tslever/Inventor/(list of files, cad)

Other CAD files:
Mobility/Additional_Building/Additional_Building.dwg
Mobility/Attic/Existing_Attic.dwg
Mobility/Basement/Existing_Basement.dwg
Mobility/Existing_House.dwg
Mobility/First_Floor/Finished_First_Floor.dwg
Mobility/Basement/Finished_Basement.dwg
Mobility/First_Floor/Existing_First_Floor.dwg
Mobility/Transition_For_Existing_Basement_And_First_Floor.dwg
Mobility/Replumbing_Mobility.dwg
Mobility/Transition_For_Finished_Basement_And_First_Floor.dwg
Mobility/Additional_Building/Additional_Building.iam
Mobility/Additional_Building/Area_With_Additional_Building.iam
Mobility/Additional_Building/Beam.iam
Mobility/Additional_Building/Beam.ipt
Mobility/Additional_Building/Bottom_Of_End_Cap_Of_Intake_Vent.ipt
Mobility/Additional_Building/Cage.iam
Mobility/Additional_Building/California_Corner.iam
Mobility/Additional_Building/Ceiling_Joist.ipt
Mobility/Additional_Building/Coil_Of_Wire.iam
Mobility/Additional_Building/Coil_Of_Wire.ipt
Mobility/Additional_Building/DensGlass.iam
Mobility/Additional_Building/DensGlass_With_Dimensions_12_x_57.9155_Inches.ipt
Mobility/Additional_Building/DensGlass_With_Dimensions_19.831_x_36.5_Inches.ipt
Mobility/Additional_Building/DensGlass_With_Dimensions_19.831_x_96_Inches.ipt
Mobility/Additional_Building/DensGlass_With_Dimensions_36.5_x_48_Inches.ipt
Mobility/Additional_Building/DensGlass_With_Dimensions_48_x_84.5_Inches.ipt
Mobility/Additional_Building/DensGlass_With_Dimensions_48_x_96_Inches.ipt
Mobility/Additional_Building/Drip_Edge_For_Back_With_Length_48.752_Inches.ipt
Mobility/Additional_Building/Drip_Edge_For_Back_With_Length_97.504_Inches.ipt
Mobility/Additional_Building/Drip_Edge_For_Front_With_Length_48.919_Inches.ipt
Mobility/Additional_Building/Drip_Edge_For_Front_With_Length_97.837_Inches.ipt
Mobility/Additional_Building/Drip_Edge_For_Side.ipt
Mobility/Additional_Building/Earth.ipt
Mobility/Additional_Building/Fascia_For_Back.ipt
Mobility/Additional_Building/Fascia_For_Front.ipt
Mobility/Additional_Building/Fascia_For_Side.ipt
Mobility/Additional_Building/Fascia_Vent_With_Length_13.75_Inches.ipt
Mobility/Additional_Building/Fascia_Vent_With_Length_14.5_Inches.ipt
Mobility/Additional_Building/Fiber_Cement_Board_For_Back_Wall.ipt
Mobility/Additional_Building/Fiber_Cement_Board_For_Side_Wall.ipt
Mobility/Additional_Building/First_Shingle_Over_Intake_Vent_With_Length_28.375_Inches.ipt
Mobility/Additional_Building/First_Shingle_Over_Intake_Vent_With_Length_30.45_Inches.ipt
Mobility/Additional_Building/First_Shingle_Over_Intake_Vent_With_Length_39.375_Inches.ipt
Mobility/Additional_Building/Floor_System.iam
Mobility/Additional_Building/Framing_For_Bathroom_Window.iam
Mobility/Additional_Building/Framing_For_First_Floor.iam
Mobility/Additional_Building/Framing_For_First_Floor_Window.iam
Mobility/Additional_Building/Framing_For_Roof.iam
Mobility/Additional_Building/Framing_For_Second_Floor.iam
Mobility/Additional_Building/Framing_For_Second_Floor_Window.iam
Mobility/Additional_Building/Framing_For_Side_Window.iam
Mobility/Additional_Building/Grid_Of_Piers.iam
Mobility/Additional_Building/Ground_Rod.ipt
Mobility/Additional_Building/Header_With_Dimensions_0.5_x_3.5_x_39_Inches.ipt
Mobility/Additional_Building/Header_With_Dimensions_0.5_x_3.5_x_41.25_Inches.ipt
Mobility/Additional_Building/Header_With_Dimensions_0.5_x_3.5_x_50.25_Inches.ipt
Mobility/Additional_Building/Header_With_Dimensions_0.5_x_5.5_x_41.25_Inches.ipt
Mobility/Additional_Building/Header_With_Dimensions_0.5_x_5.5_x_50.25_Inches.ipt
Mobility/Additional_Building/Header_With_Dimensions_1.5_x_3.5_x_39_Inches.ipt
Mobility/Additional_Building/Header_With_Dimensions_1.5_x_3.5_x_41.25_Inches.ipt
Mobility/Additional_Building/Header_With_Dimensions_1.5_x_3.5_x_50.25_Inches.ipt
Mobility/Additional_Building/Header_With_Dimensions_1.5_x_5.5_x_41.25_Inches.ipt
Mobility/Additional_Building/Header_With_Dimensions_1.5_x_5.5_x_50.25_Inches.ipt
Mobility/Additional_Building/Header_With_Dimensions_3.5_x_3.5_x_39_Inches.iam
Mobility/Additional_Building/Header_With_Dimensions_3.5_x_3.5_x_41.25_Inches.iam
Mobility/Additional_Building/Header_With_Dimensions_3.5_x_3.5_x_50.25_Inches.iam
Mobility/Additional_Building/Header_With_Dimensions_3.5_x_5.5_x_41.25_Inches.iam
Mobility/Additional_Building/Header_With_Dimensions_3.5_x_5.5_x_50.25_Inches.iam
Mobility/Additional_Building/Intake_Vent.ipt
Mobility/Additional_Building/Joist_With_Length_144_Inches.ipt
Mobility/Additional_Building/Joist_With_Length_56.75_Inches.ipt
Mobility/Additional_Building/Joist_With_Length_6.5_Inches.ipt
Mobility/Additional_Building/Leak_Barrier.ipt
Mobility/Additional_Building/Maple_Tree.ipt
Mobility/Additional_Building/Mending_Plate.ipt
Mobility/Additional_Building/OSB_For_Front_Roof.ipt
Mobility/Additional_Building/OSB_For_Rear_Roof.ipt
Mobility/Additional_Building/OSB_For_Roof_With_Dimensions_47.416_x_96.ipt
Mobility/Additional_Building/OSB_For_Roof_With_Dimensions_48_x_48.ipt
Mobility/Additional_Building/OSB_For_Roof_With_Dimensions_48_x_96.ipt
Mobility/Additional_Building/OSB_For_Side_And_Back.ipt
Mobility/Additional_Building/OSB_For_Side_And_Top.ipt
Mobility/Additional_Building/OSB_For_Subfloor_With_Dimensions_48_x_48_Inches.ipt
Mobility/Additional_Building/OSB_For_Subfloor_With_Dimensions_96_x_36_Inches.ipt
Mobility/Additional_Building/OSB_For_Subfloor_With_Dimensions_96_x_48_Inches.ipt
Mobility/Additional_Building/OSB_For_Walls_With_Dimensions_15.459_x_48_Inches.ipt
Mobility/Additional_Building/OSB_For_Walls_With_Dimensions_15.459_x_96_Inches.ipt
Mobility/Additional_Building/OSB_For_Walls_With_Dimensions_19.831_x_96_Inches.ipt
Mobility/Additional_Building/OSB_For_Walls_With_Dimensions_37_x_48_Inches.ipt
Mobility/Additional_Building/OSB_For_Walls_With_Dimensions_38.375_x_40.979_Inches.ipt
Mobility/Additional_Building/OSB_For_Walls_With_Dimensions_48_x_48_Inches.ipt
Mobility/Additional_Building/OSB_For_Walls_With_Dimensions_48_x_85_Inches.ipt
Mobility/Additional_Building/OSB_For_Walls_With_Dimensions_48_x_96_Inches.ipt
Mobility/Additional_Building/Pier.iam
Mobility/Additional_Building/Pier.ipt
Mobility/Additional_Building/Plate_With_Length_125_Inches.ipt
Mobility/Additional_Building/Plate_With_Length_132_Inches.ipt
Mobility/Additional_Building/Plate_With_Length_144_Inches.ipt
Mobility/Additional_Building/Plate_With_Length_25_Inches.ipt
Mobility/Additional_Building/Plate_With_Length_60_Inches.ipt
Mobility/Additional_Building/Plate_With_Length_68.5_Inches.ipt
Mobility/Additional_Building/Plate_With_Length_72_Inches.ipt
Mobility/Additional_Building/Plate_With_Length_83.350_Inches.ipt
Mobility/Additional_Building/Plate_With_Length_96_Inches.ipt
Mobility/Additional_Building/Rafter.ipt
Mobility/Additional_Building/Rebar_With_Length_Of_31.56275_Inches.ipt
Mobility/Additional_Building/Rectangle_Of_Underlayment_For_Beam.ipt
Mobility/Additional_Building/Rectangle_Of_Underlayment_For_Joist.ipt
Mobility/Additional_Building/Ring_Of_Rebar.ipt
Mobility/Additional_Building/Saddle_Bracket.ipt
Mobility/Additional_Building/Second_Shingle_Over_Intake_Vent_With_Length_22.375_Inches.ipt
Mobility/Additional_Building/Second_Shingle_Over_Intake_Vent_With_Length_36.45_Inches.ipt
Mobility/Additional_Building/Second_Shingle_Over_Intake_Vent_With_Length_39.375_Inches.ipt
Mobility/Additional_Building/Sheathing_For_Back.iam
Mobility/Additional_Building/Sheathing_For_Front.iam
Mobility/Additional_Building/Sheathing_For_Roof.iam
Mobility/Additional_Building/Sheathing_For_Side.iam
Mobility/Additional_Building/Shingle_With_Dimensions_13.25_x_19.45_Inches.ipt
Mobility/Additional_Building/Shingle_With_Dimensions_13.25_x_22.375_Inches.ipt
Mobility/Additional_Building/Shingle_With_Dimensions_13.25_x_25.45_Inches.ipt
Mobility/Additional_Building/Shingle_With_Dimensions_13.25_x_28.375_Inches.ipt
Mobility/Additional_Building/Shingle_With_Dimensions_13.25_x_30.45_Inches.ipt
Mobility/Additional_Building/Shingle_With_Dimensions_13.25_x_33.375_Inches.ipt
Mobility/Additional_Building/Shingle_With_Dimensions_13.25_x_36.45_Inches.ipt
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
