tslever/Inventor/Mobility/Additional_Building/Additional_Building.pdf

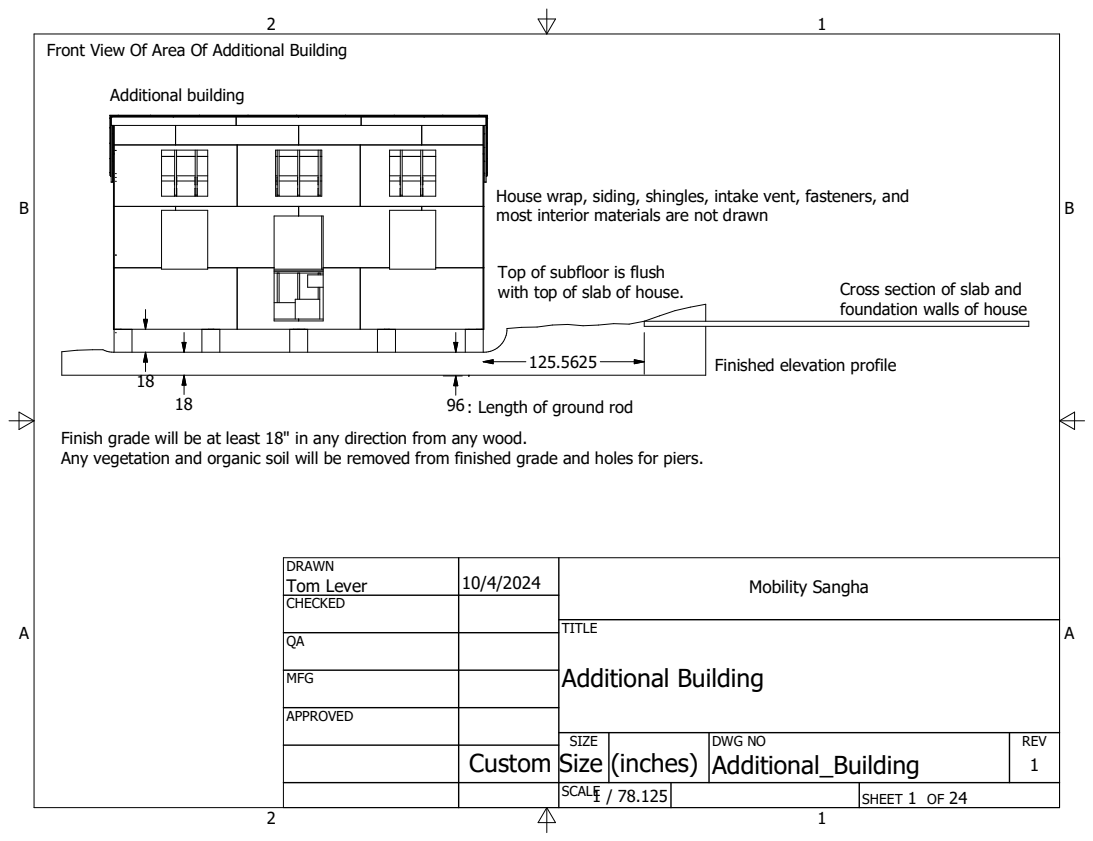
[picture p5: page 1]
SHEET 1 OF 24; DWG NO Additional_Building; TITLE Additional Building; SIZE; SCALE; REV 1; Additional building

Front View Of Area Of Additional Building

House wrap, siding, shingles, intake vent, fasteners, and
most interior materials are not drawn

Top of subfloor is flush
with top of slab of house.

Cross section of slab and
foundation walls of house

Finished elevation profile

96: Length of ground rod

Finish grade will be at least 18" in any direction from any wood.
Any vegetation and organic soil will be removed from finished grade and holes for piers.

DRAWN Tom Lever | 10/4/2024 | Mobility Sangha

CHECKED

MFG

APPROVED

Custom Size (inches)

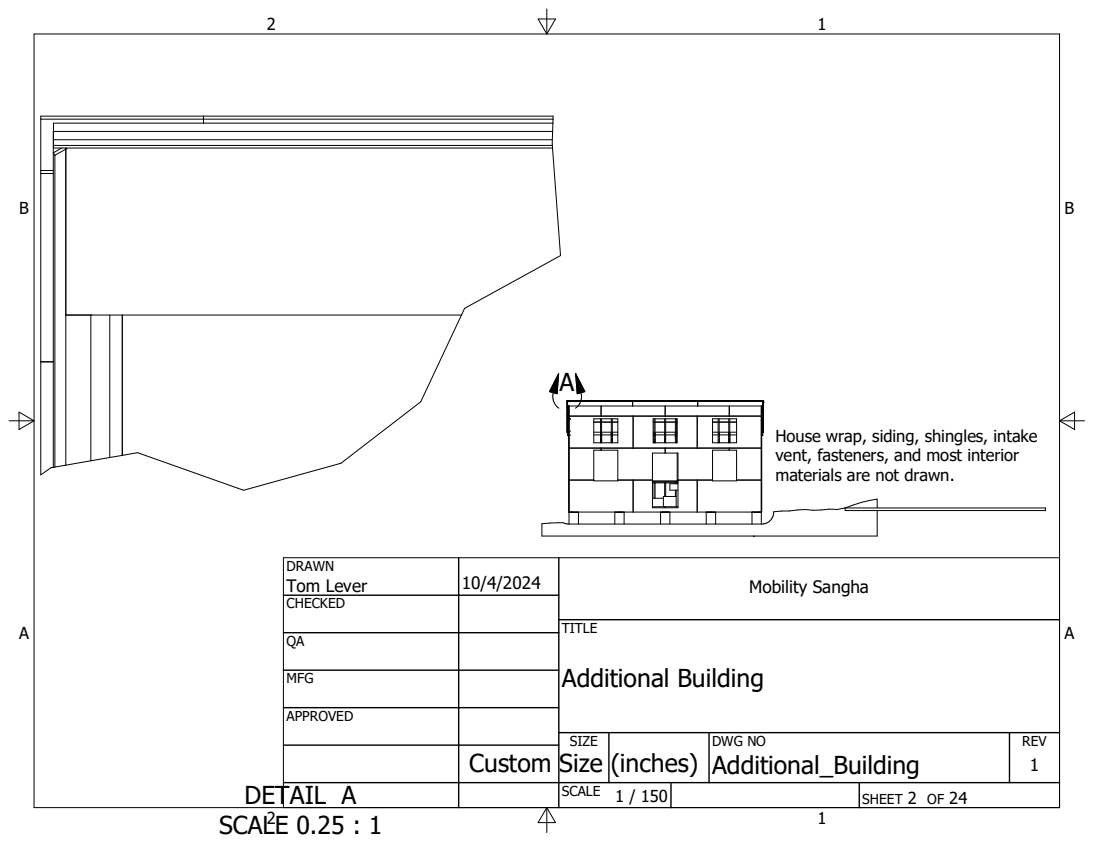
[picture p6: page 2]
DETAIL A SCALE 0.25 : 1; SHEET 2 OF 24; DWG NO Additional_Building; TITLE Additional Building; SIZE; REV 1

House wrap, siding, shingles, intake
vent, fasteners, and most interior
materials are not drawn.

DRAWN Tom Lever | 10/4/2024 | Mobility Sangha

CHECKED

MFG

APPROVED

Custom Size (inches)

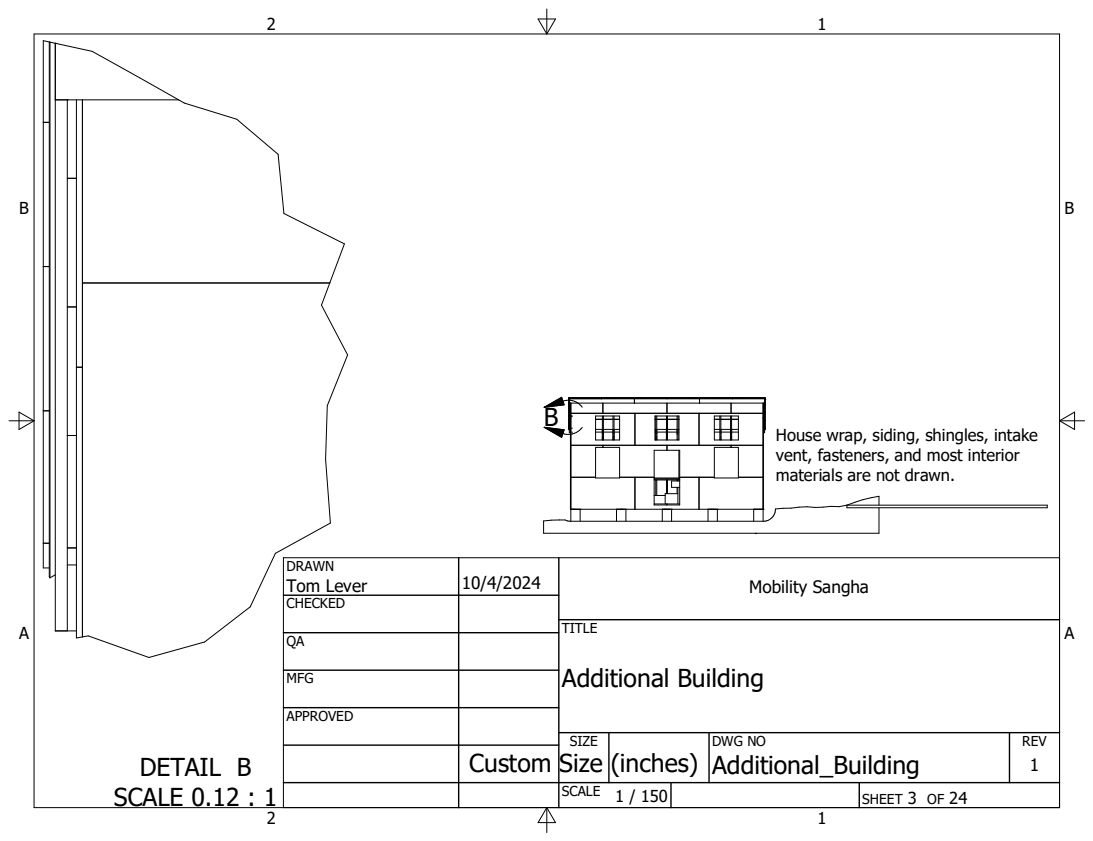
[picture p7: page 3]
DETAIL B SCALE 0.12 : 1; SHEET 3 OF 24; DWG NO Additional_Building; TITLE Additional Building; SIZE; REV 1

House wrap, siding, shingles, intake
vent, fasteners, and most interior
materials are not drawn.

DRAWN Tom Lever | 10/4/2024 | Mobility Sangha

CHECKED

MFG

APPROVED

Custom Size (inches)

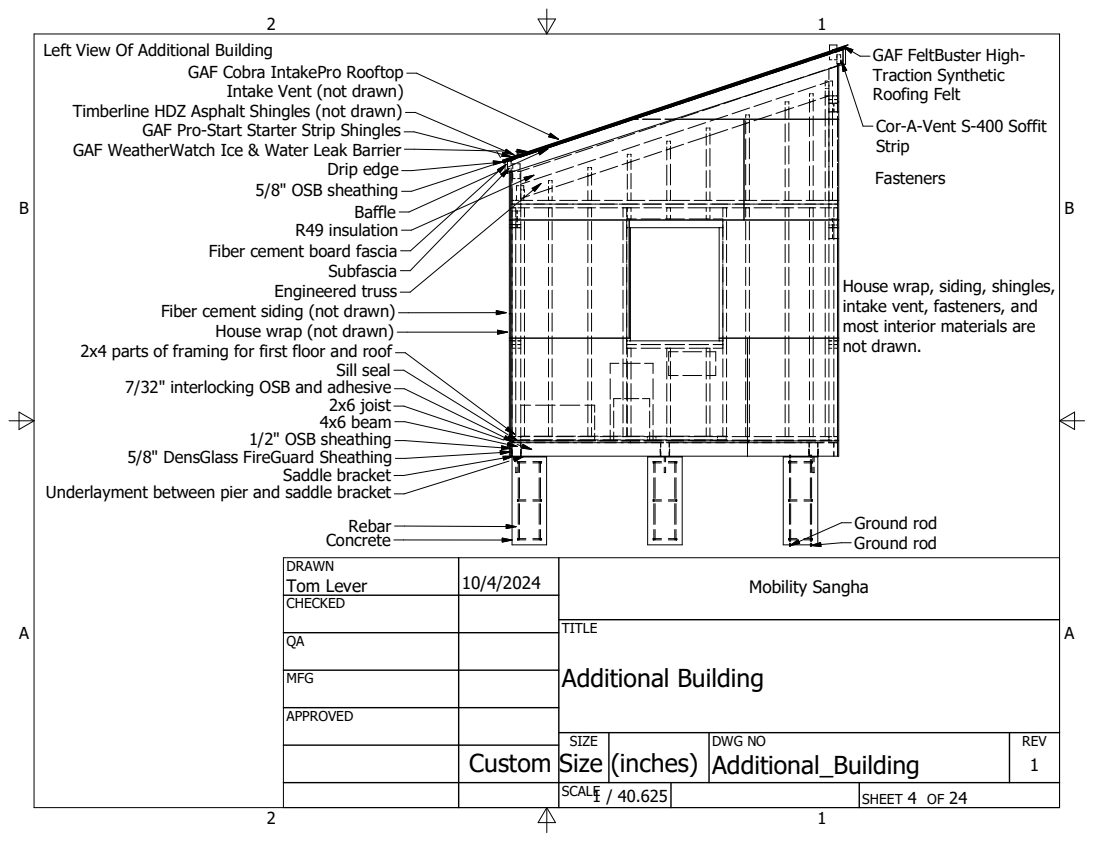
[picture p8: page 4]
SHEET 4 OF 24; DWG NO Additional_Building; TITLE Additional Building; SIZE; REV 1; Concrete; Saddle bracket; 1/2" OSB sheathing; 4x6 beam; 2x6 joist; Sill seal; Engineered truss; Subfascia; Drip edge 5/8" OSB sheathing; R49 insulation; Baffle; Rebar; Ground rod

Left View Of Additional Building

GAF FeltBuster High-
Traction Synthetic
Roofing Felt
Cor-A-Vent S-400 Soffit
Strip
Fasteners

GAF Cobra IntakePro Rooftop
Intake Vent (not drawn)

Timberline HDZ Asphalt Shingles (not drawn)

GAF Pro-Start Starter Strip Shingles

GAF WeatherWatch Ice & Water Leak Barrier

Fiber cement board fascia

House wrap, siding, shingles,
intake vent, fasteners, and
most interior materials are
not drawn.

Fiber cement siding (not drawn)
House wrap (not drawn)

2x4 parts of framing for first floor and roof
7/32" interlocking OSB and adhesive

5/8" DensGlass FireGuard Sheathing

Underlayment between pier and saddle bracket

DRAWN Tom Lever | 10/4/2024 | Mobility Sangha

CHECKED

MFG

APPROVED

Custom Size (inches)

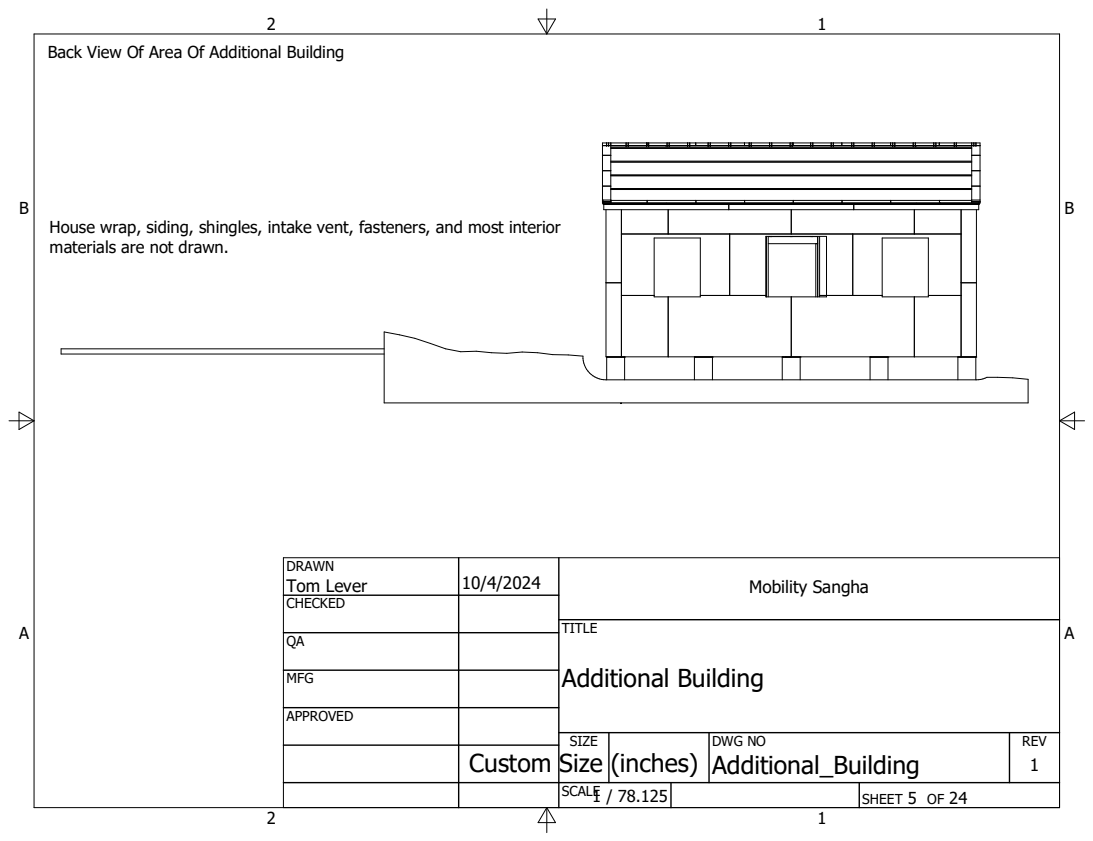
[picture p9: page 5]
SHEET 5 OF 24; DWG NO Additional_Building; TITLE Additional Building; SIZE; REV 1

Back View Of Area Of Additional Building

House wrap, siding, shingles, intake vent, fasteners, and most interior
materials are not drawn.

DRAWN Tom Lever | 10/4/2024 | Mobility Sangha

CHECKED

MFG

APPROVED

Custom Size (inches)

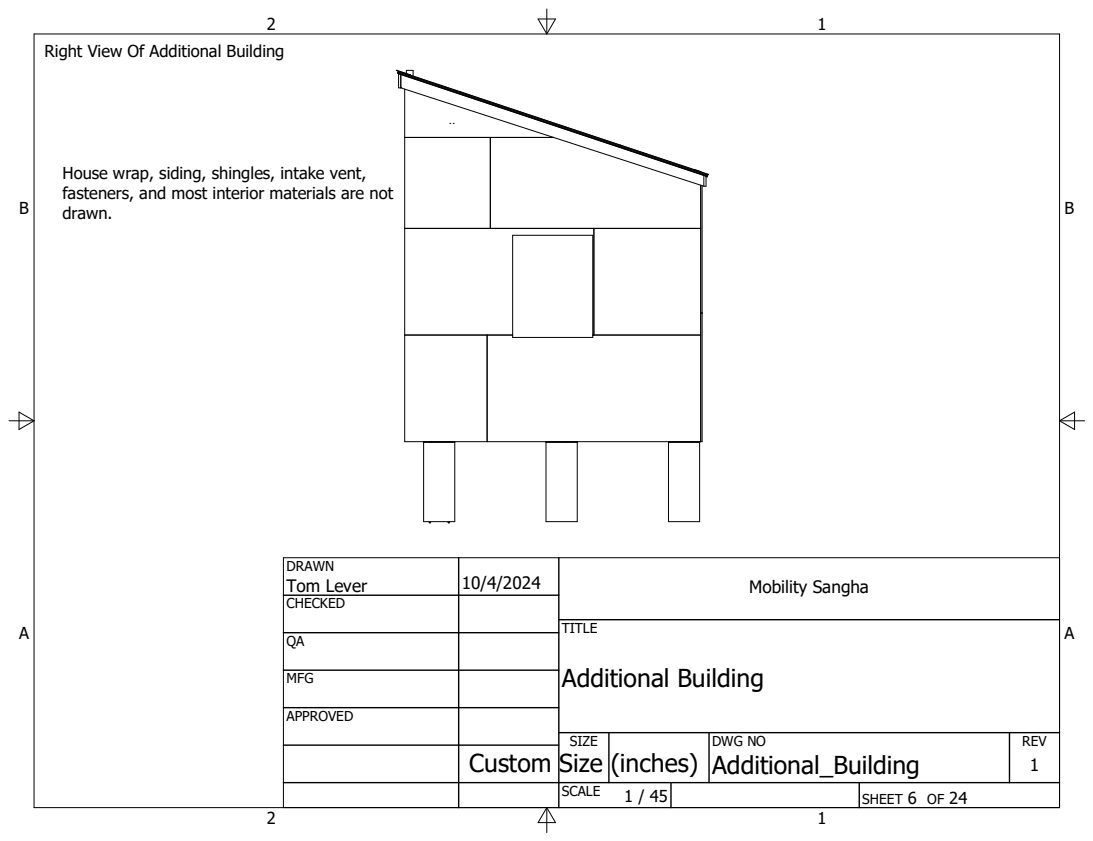
[picture p10: page 6]
SHEET 6 OF 24; DWG NO Additional_Building; TITLE Additional Building; SIZE; REV 1

Right View Of Additional Building

House wrap, siding, shingles, intake vent,
fasteners, and most interior materials are not
drawn.

DRAWN Tom Lever | 10/4/2024 | Mobility Sangha

CHECKED

MFG

APPROVED

Custom Size (inches)

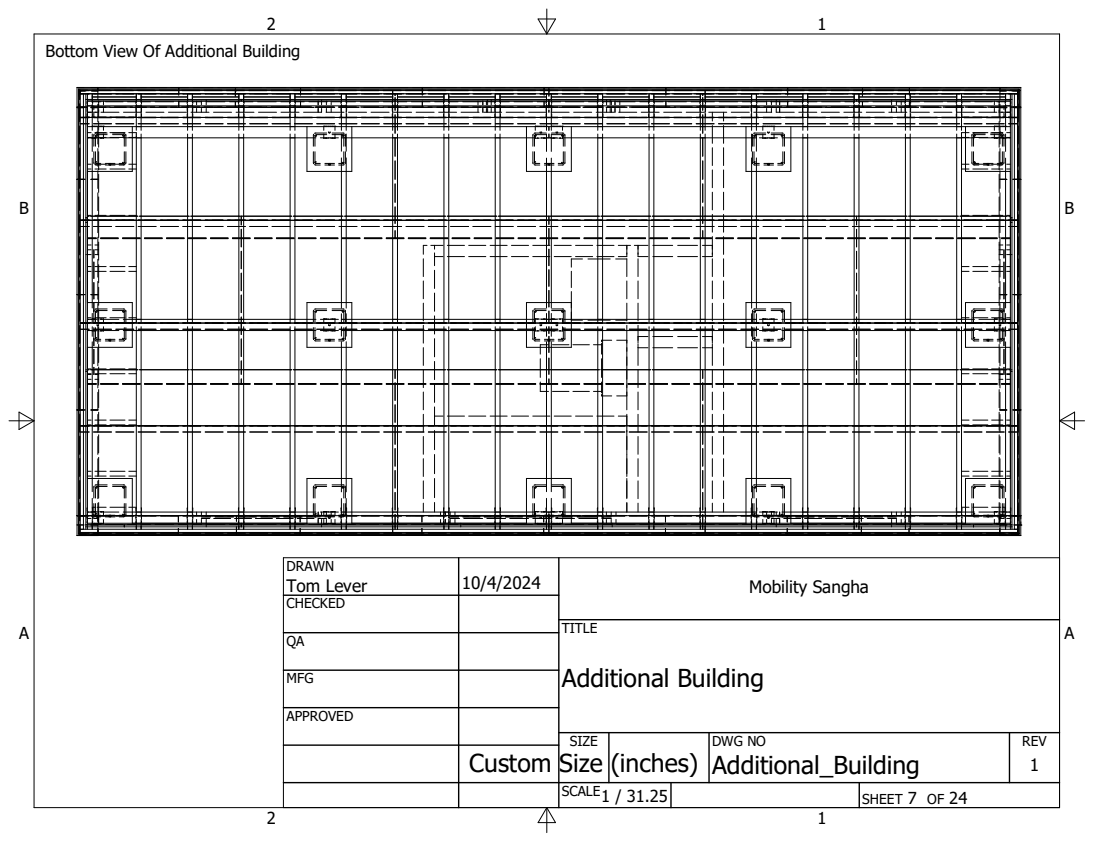
[picture p11: page 7]
SHEET 7 OF 24; DRAWN; CHECKED; MFG; APPROVED; Tom Lever; DWG NO Additional_Building; TITLE Additional Building; SIZE; Mobility Sangha; REV 1

Bottom View Of Additional Building

Custom Size (inches)

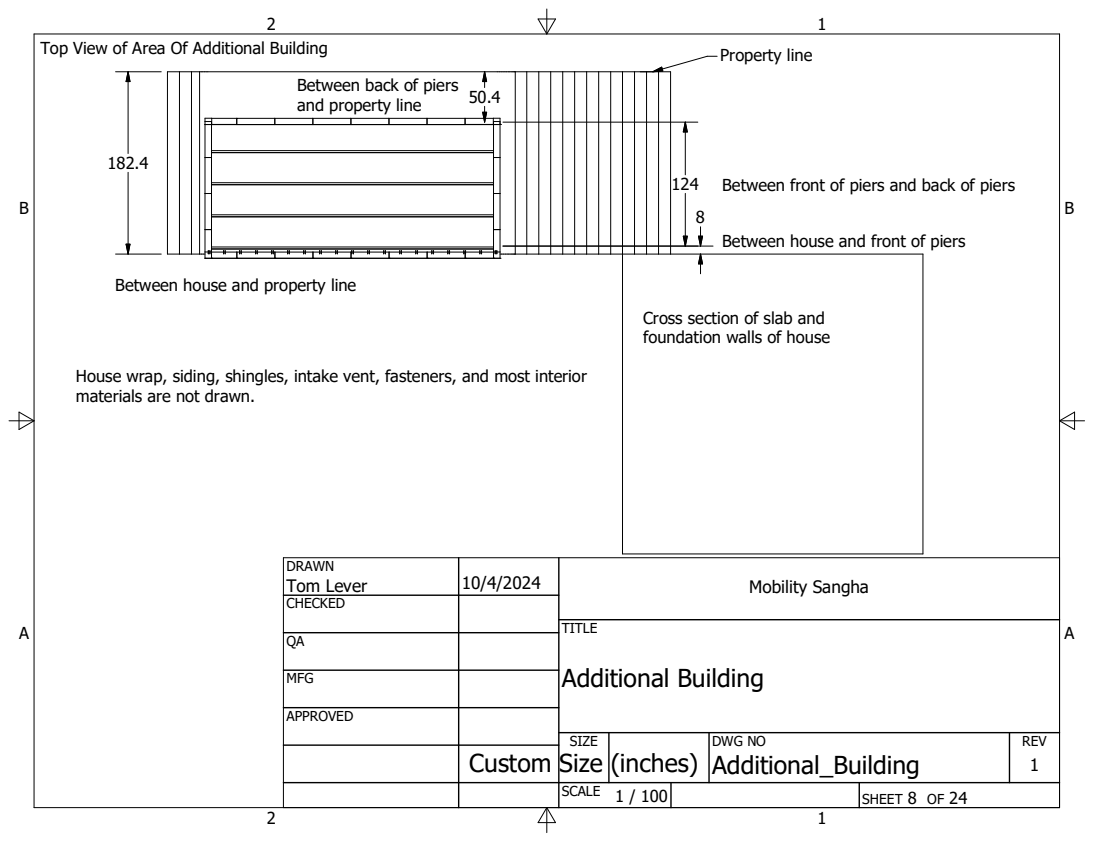
[picture p12: page 8]
SHEET 8 OF 24; DWG NO Additional_Building; TITLE Additional Building; SIZE; REV 1; Property line

Top View of Area Of Additional Building

Between back of piers
and property line

Between front of piers and back of piers
Between house and front of piers

Between house and property line

Cross section of slab and
foundation walls of house

House wrap, siding, shingles, intake vent, fasteners, and most interior
materials are not drawn.

DRAWN Tom Lever | 10/4/2024 | Mobility Sangha

CHECKED

MFG

APPROVED

Custom Size (inches)

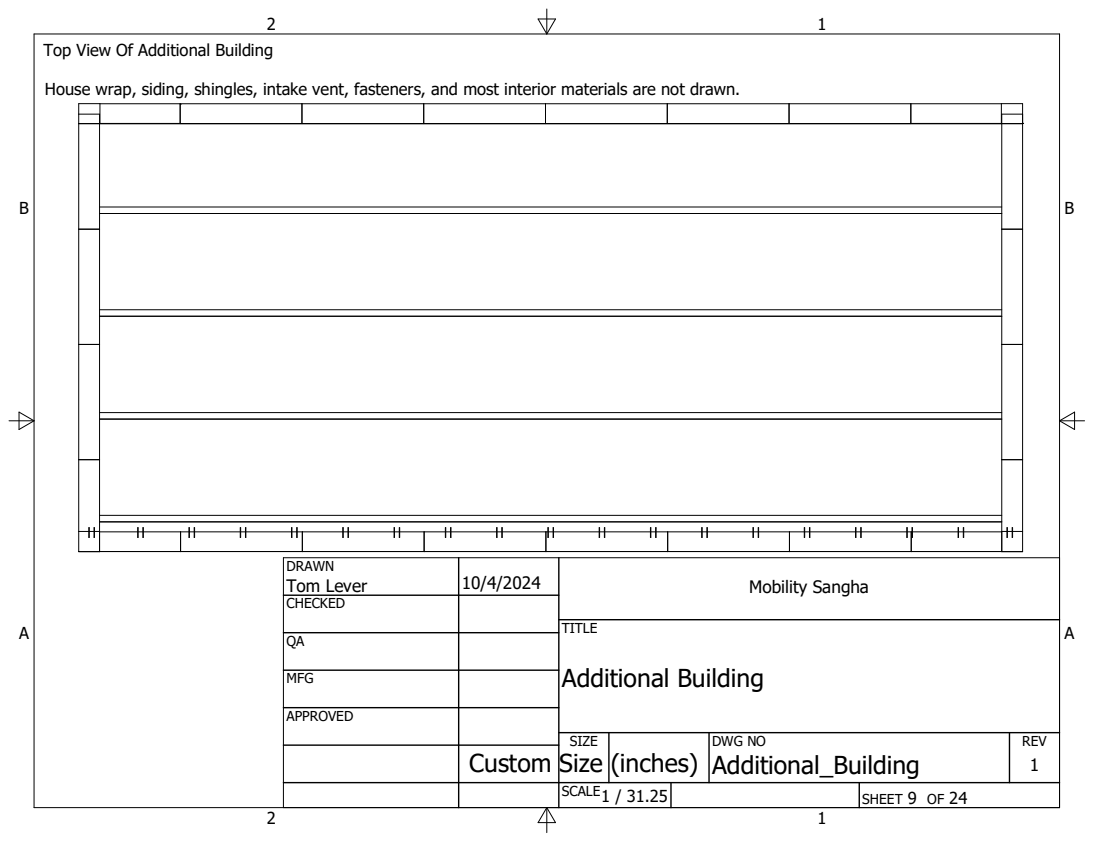
[picture p13: page 9]
SHEET 9 OF 24; DWG NO Additional_Building; TITLE Additional Building; SIZE; REV 1

Top View Of Additional Building

House wrap, siding, shingles, intake vent, fasteners, and most interior materials are not drawn.

DRAWN Tom Lever | 10/4/2024 | Mobility Sangha

CHECKED

MFG

APPROVED

Custom Size (inches)

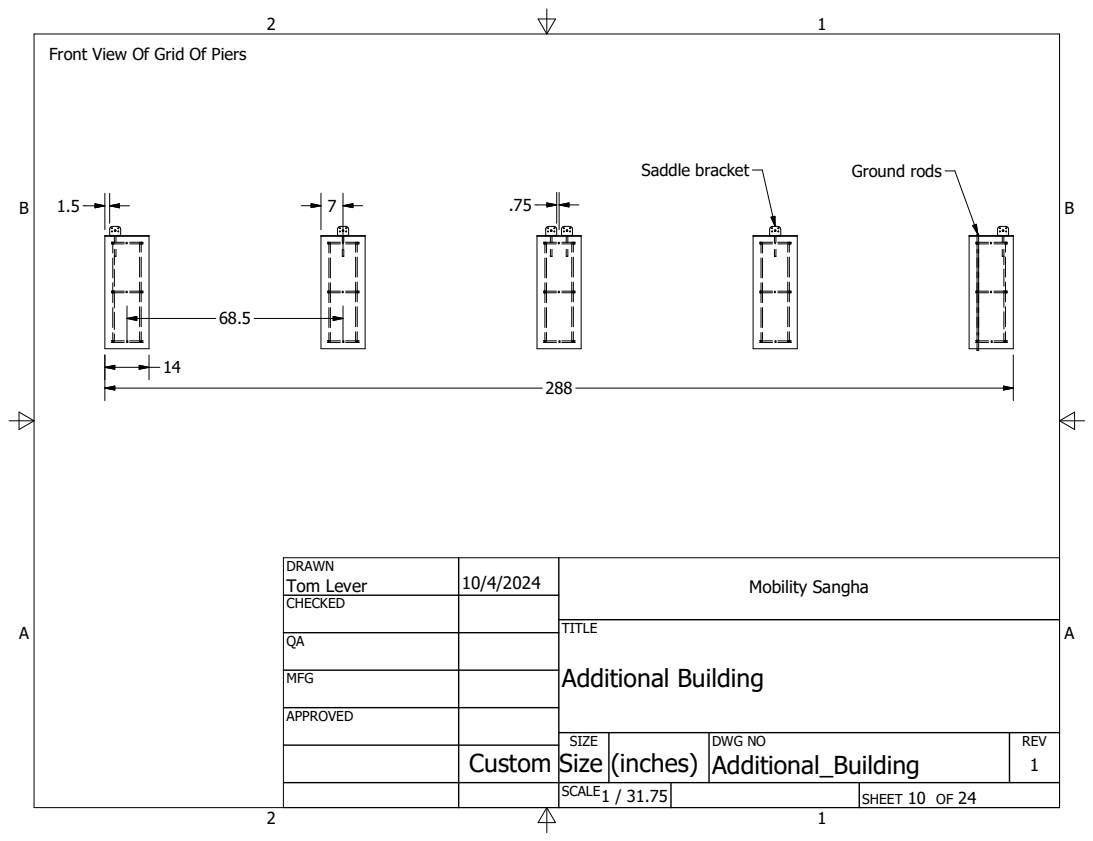
[picture p14: page 10]
SHEET 10 OF 24; DWG NO Additional_Building; TITLE Additional Building; SIZE; REV 1; Saddle bracket; Ground rods

Front View Of Grid Of Piers

DRAWN Tom Lever | 10/4/2024 | Mobility Sangha

CHECKED

MFG

APPROVED

Custom Size (inches)

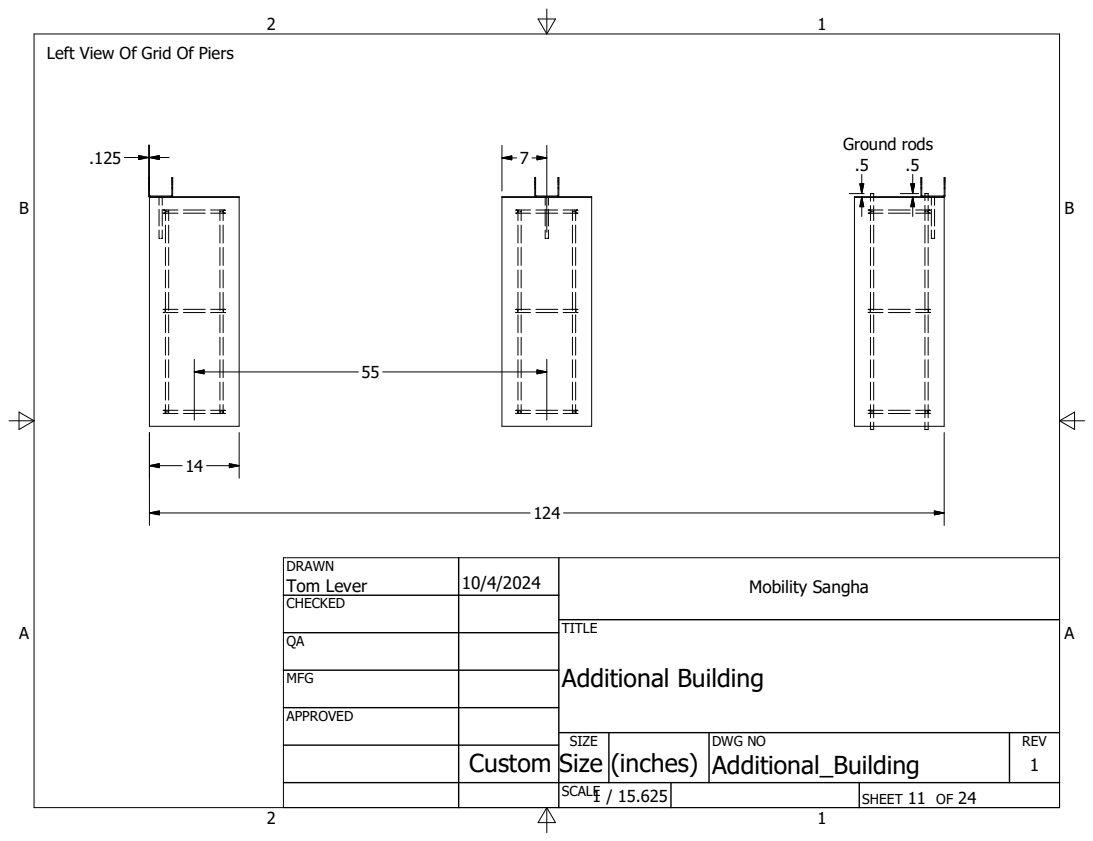
[picture p15: page 11]
SHEET 11 OF 24; DWG NO Additional_Building; TITLE Additional Building; SIZE; REV 1; Ground rods

Left View Of Grid Of Piers

DRAWN Tom Lever | 10/4/2024 | Mobility Sangha

CHECKED

MFG

APPROVED

Custom Size (inches)

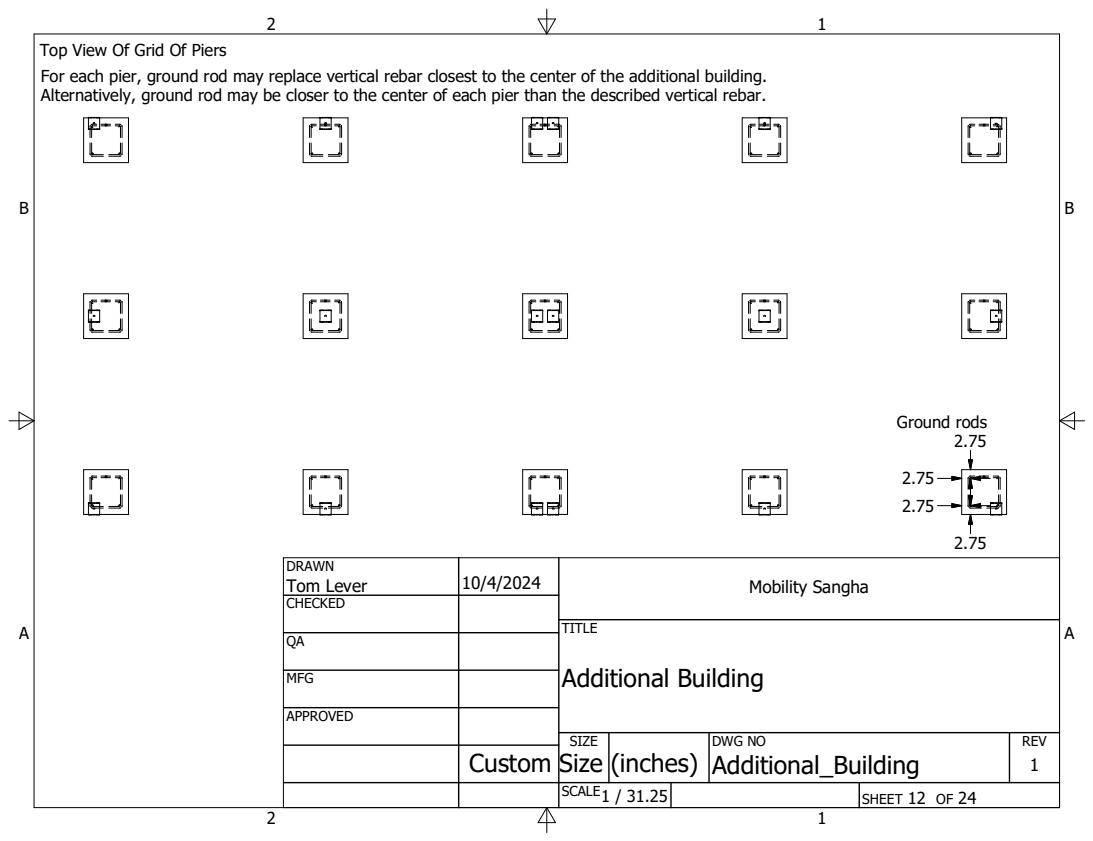
[picture p16: page 12]
SHEET 12 OF 24; DWG NO Additional_Building; TITLE Additional Building; SIZE; REV 1; Ground rods

Top View Of Grid Of Piers
For each pier, ground rod may replace vertical rebar closest to the center of the additional building.
Alternatively, ground rod may be closer to the center of each pier than the described vertical rebar.

DRAWN Tom Lever | 10/4/2024 | Mobility Sangha

CHECKED

MFG

APPROVED

Custom Size (inches)

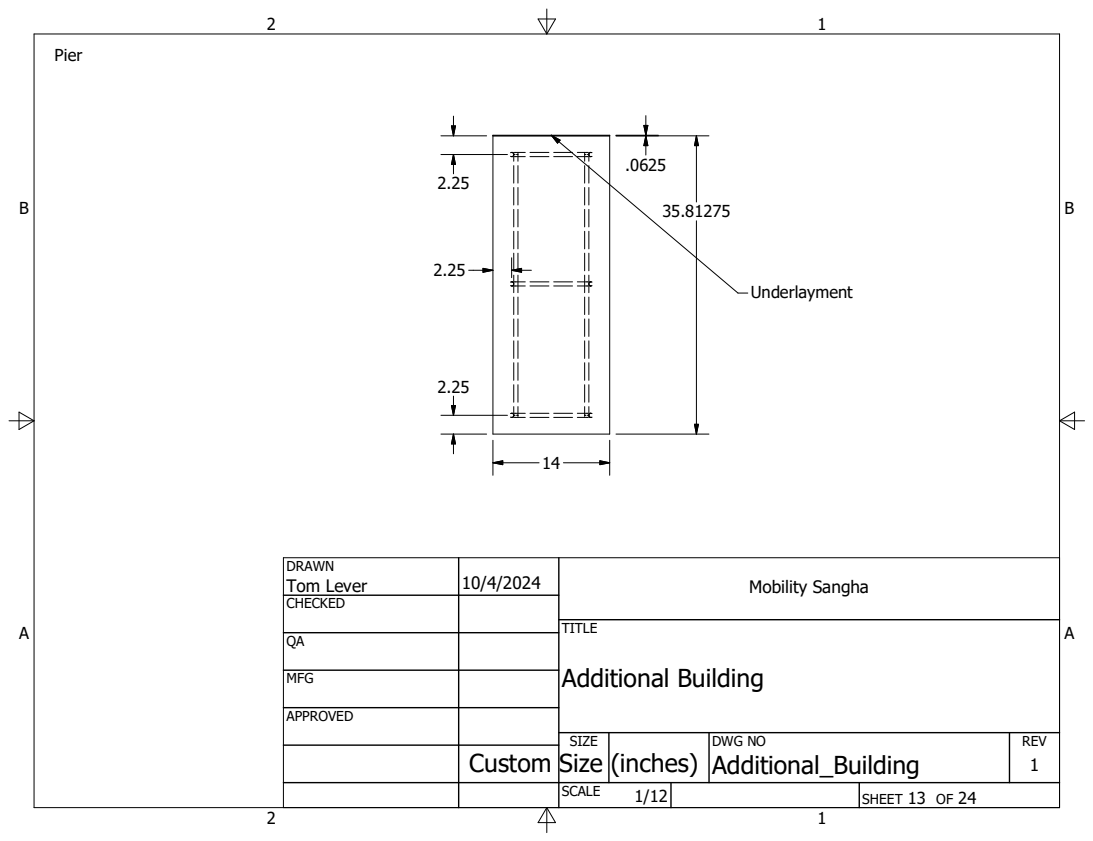
[picture p17: page 13]
SHEET 13 OF 24; DWG NO Additional_Building; TITLE Additional Building; SIZE; REV 1; Pier; Underlayment

DRAWN Tom Lever | 10/4/2024 | Mobility Sangha

CHECKED

MFG

APPROVED

Custom Size (inches)

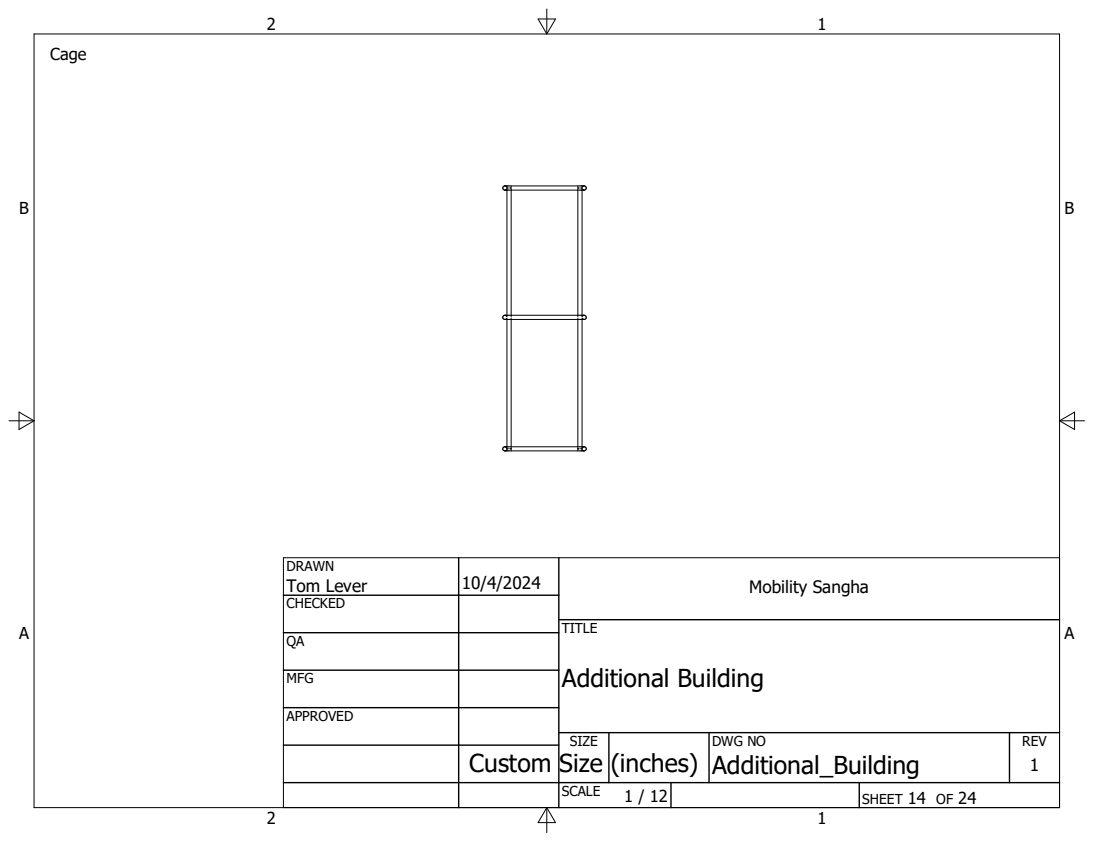
[picture p18: page 14]
SHEET 14 OF 24; DWG NO Additional_Building; TITLE Additional Building; SIZE; REV 1; Cage

DRAWN Tom Lever | 10/4/2024 | Mobility Sangha

CHECKED

MFG

APPROVED

Custom Size (inches)

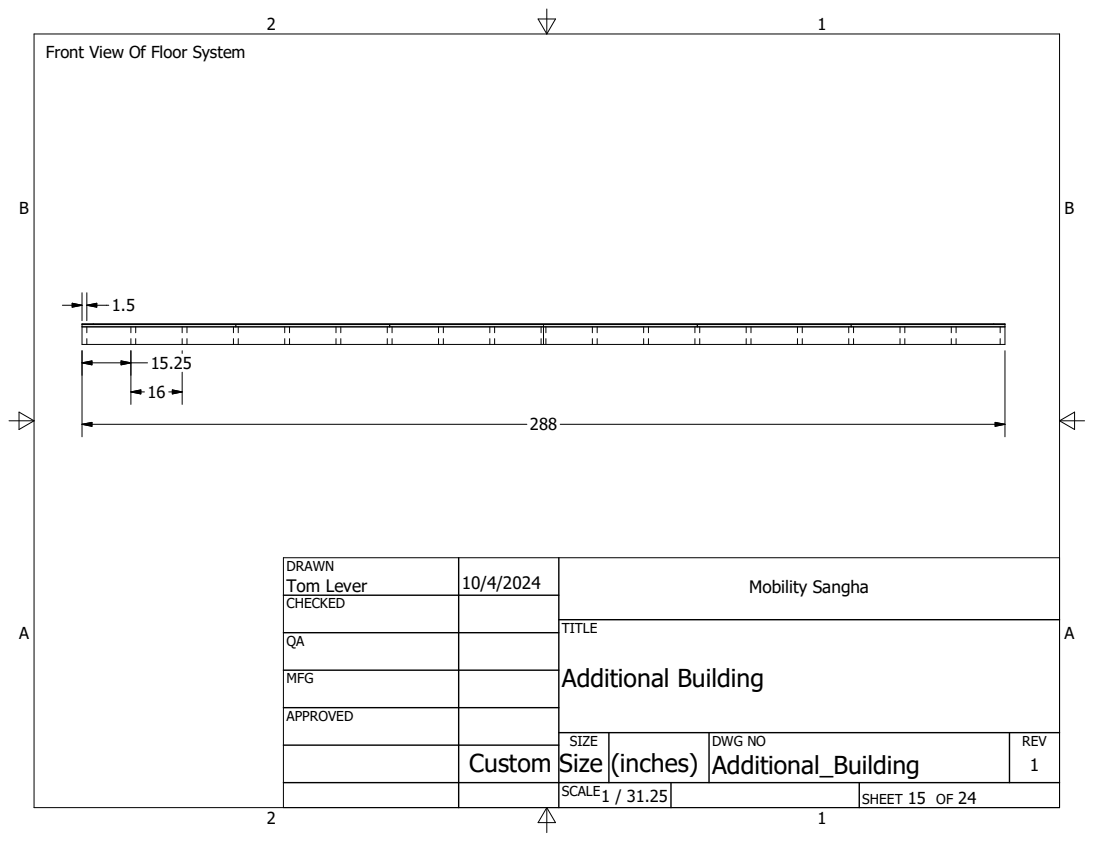
[picture p19: page 15]
SHEET 15 OF 24; DWG NO Additional_Building; TITLE Additional Building; SIZE; REV 1

Front View Of Floor System

DRAWN Tom Lever | 10/4/2024 | Mobility Sangha

CHECKED

MFG

APPROVED

Custom Size (inches)

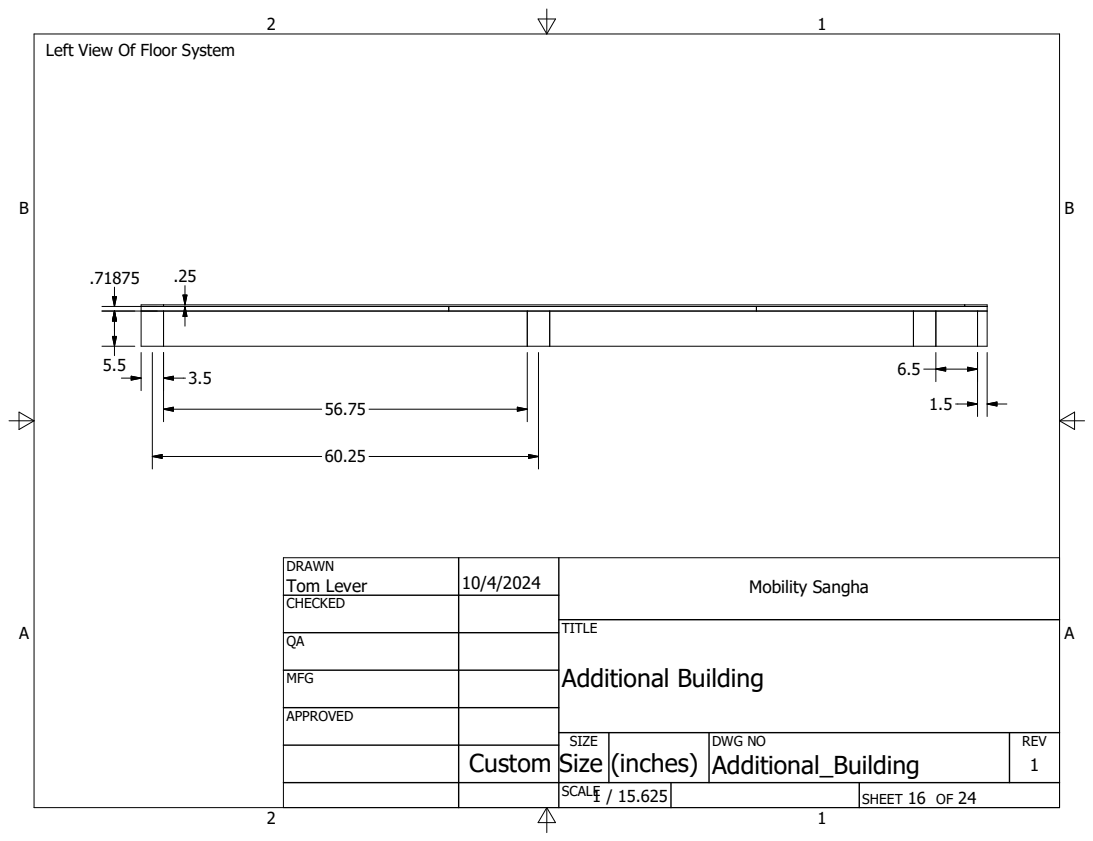
[picture p20: page 16]
SHEET 16 OF 24; DWG NO Additional_Building; TITLE Additional Building; SIZE; REV 1

Left View Of Floor System

DRAWN Tom Lever | 10/4/2024 | Mobility Sangha

CHECKED

MFG

APPROVED

Custom Size (inches)

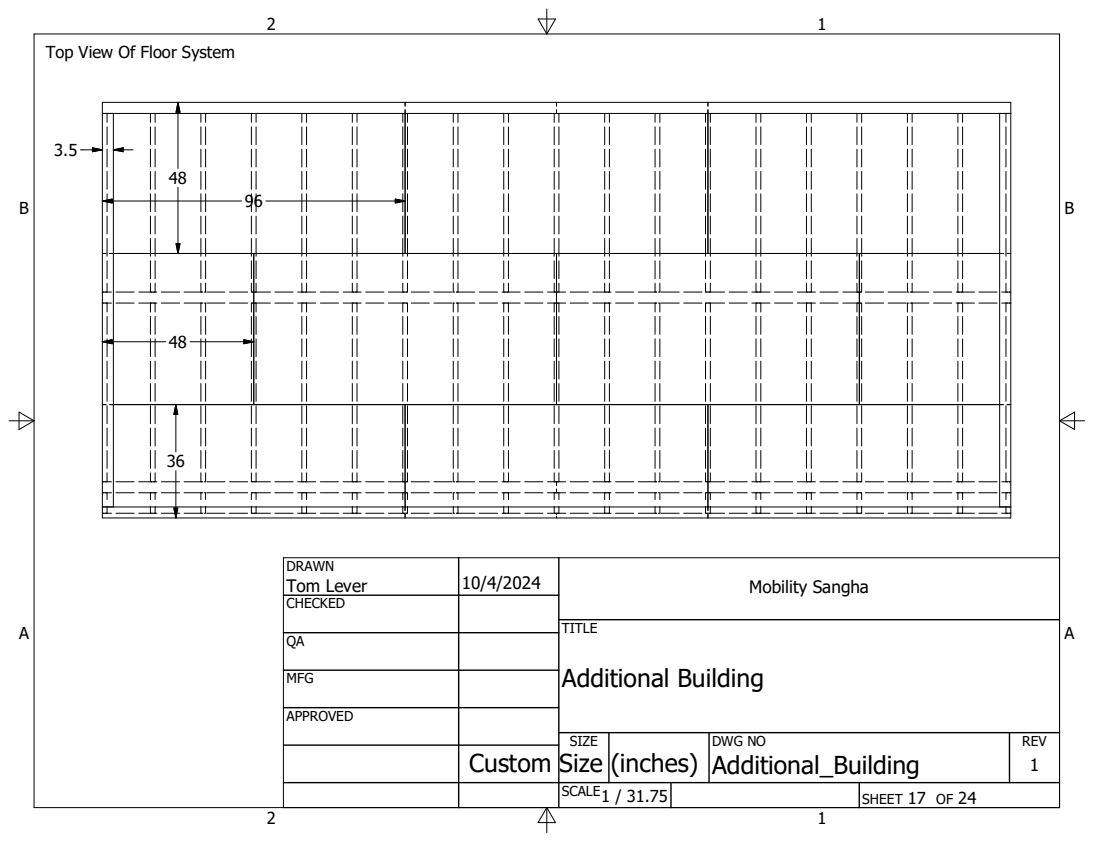
[picture p21: page 17]
SHEET 17 OF 24; DWG NO Additional_Building; TITLE Additional Building; SIZE; REV 1

Top View Of Floor System

DRAWN Tom Lever | 10/4/2024 | Mobility Sangha

CHECKED

MFG

APPROVED

Custom Size (inches)

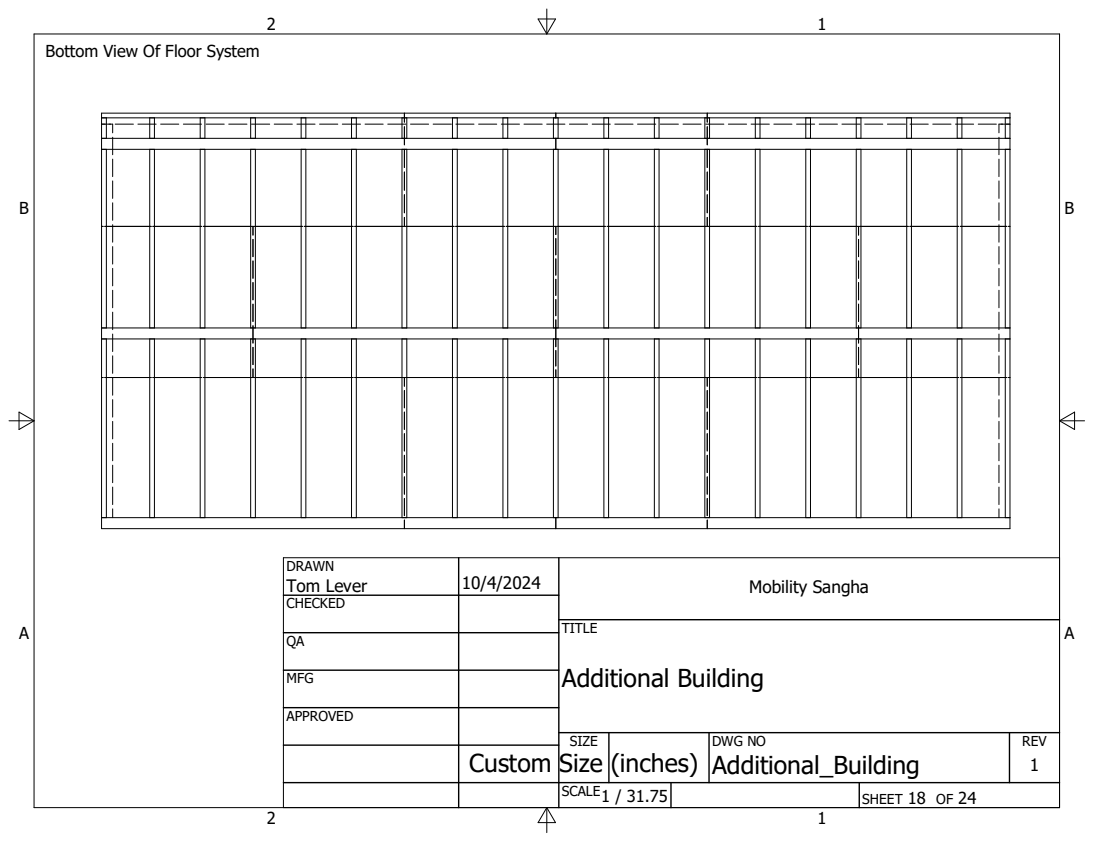
[picture p22: page 18]
SHEET 18 OF 24; DWG NO Additional_Building; TITLE Additional Building; SIZE; REV 1

Bottom View Of Floor System

DRAWN Tom Lever | 10/4/2024 | Mobility Sangha

CHECKED

MFG

APPROVED

Custom Size (inches)

C C

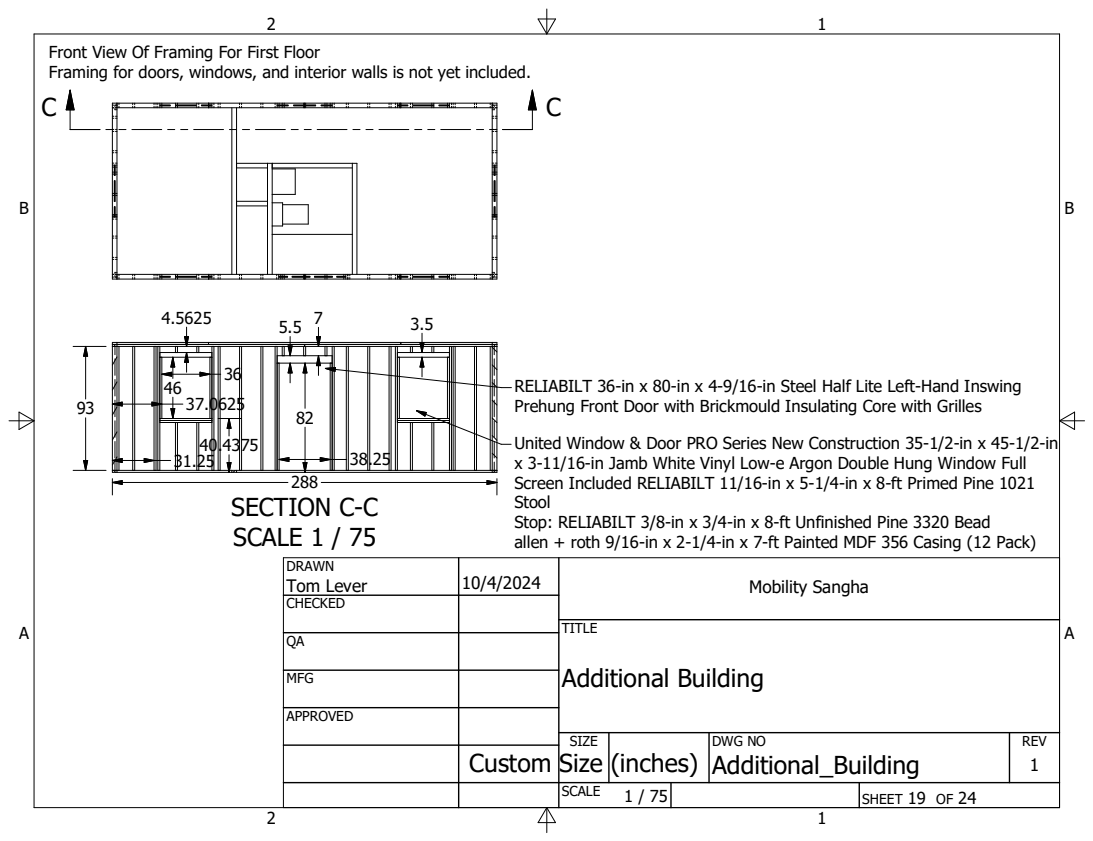
[picture p23: page 19]
SECTION C-C SCALE 1 / 75; SHEET 19 OF 24; DWG NO Additional_Building; TITLE Additional Building; SIZE; REV 1

Front View Of Framing For First Floor
Framing for doors, windows, and interior walls is not yet included.

RELIABILT 36-in x 80-in x 4-9/16-in Steel Half Lite Left-Hand Inswing
Prehung Front Door with Brickmould Insulating Core with Grilles
United Window & Door PRO Series New Construction 35-1/2-in x 45-1/2-in
x 3-11/16-in Jamb White Vinyl Low-e Argon Double Hung Window Full
Screen Included RELIABILT 11/16-in x 5-1/4-in x 8-ft Primed Pine 1021
Stool
Stop: RELIABILT 3/8-in x 3/4-in x 8-ft Unfinished Pine 3320 Bead
allen + roth 9/16-in x 2-1/4-in x 7-ft Painted MDF 356 Casing (12 Pack)

DRAWN Tom Lever | 10/4/2024 | Mobility Sangha

CHECKED

MFG

APPROVED

Custom Size (inches)

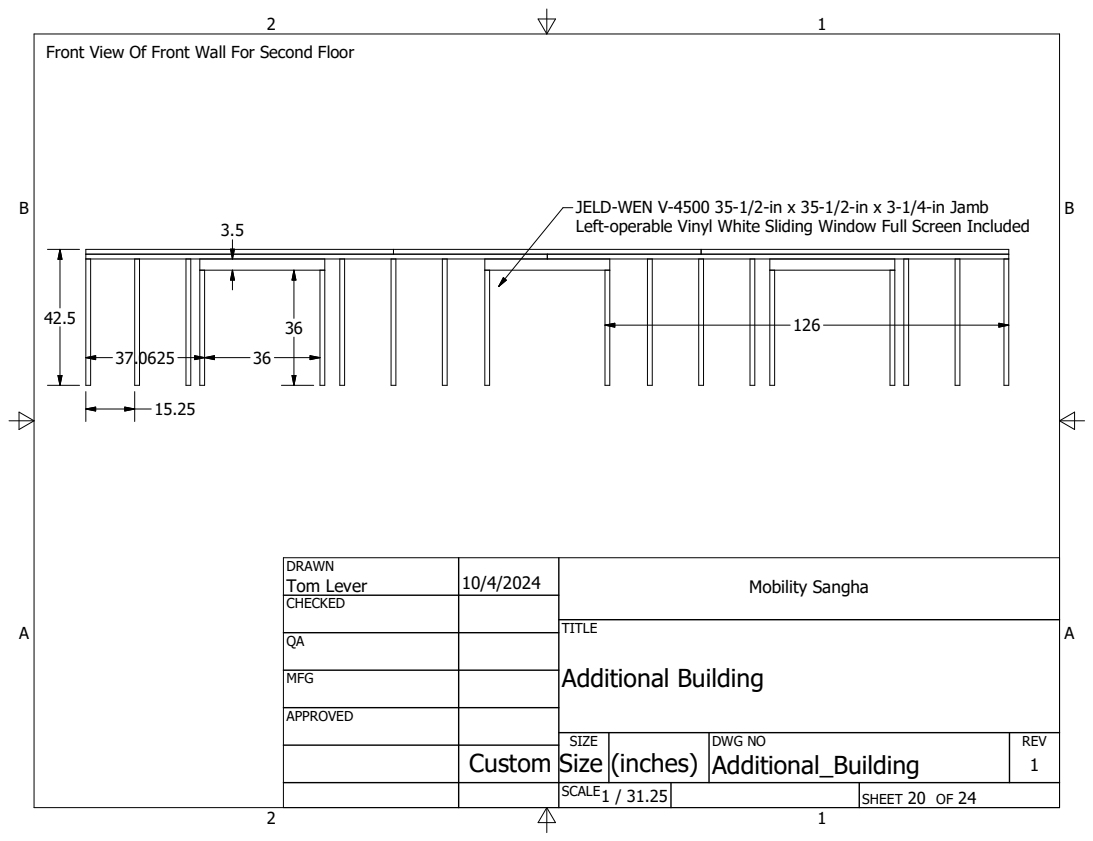
[picture p24: page 20]
SHEET 20 OF 24; DWG NO Additional_Building; TITLE Additional Building; SIZE; REV 1

Front View Of Front Wall For Second Floor

JELD-WEN V-4500 35-1/2-in x 35-1/2-in x 3-1/4-in Jamb
Left-operable Vinyl White Sliding Window Full Screen Included

DRAWN Tom Lever | 10/4/2024 | Mobility Sangha

CHECKED

MFG

APPROVED

Custom Size (inches)

D D

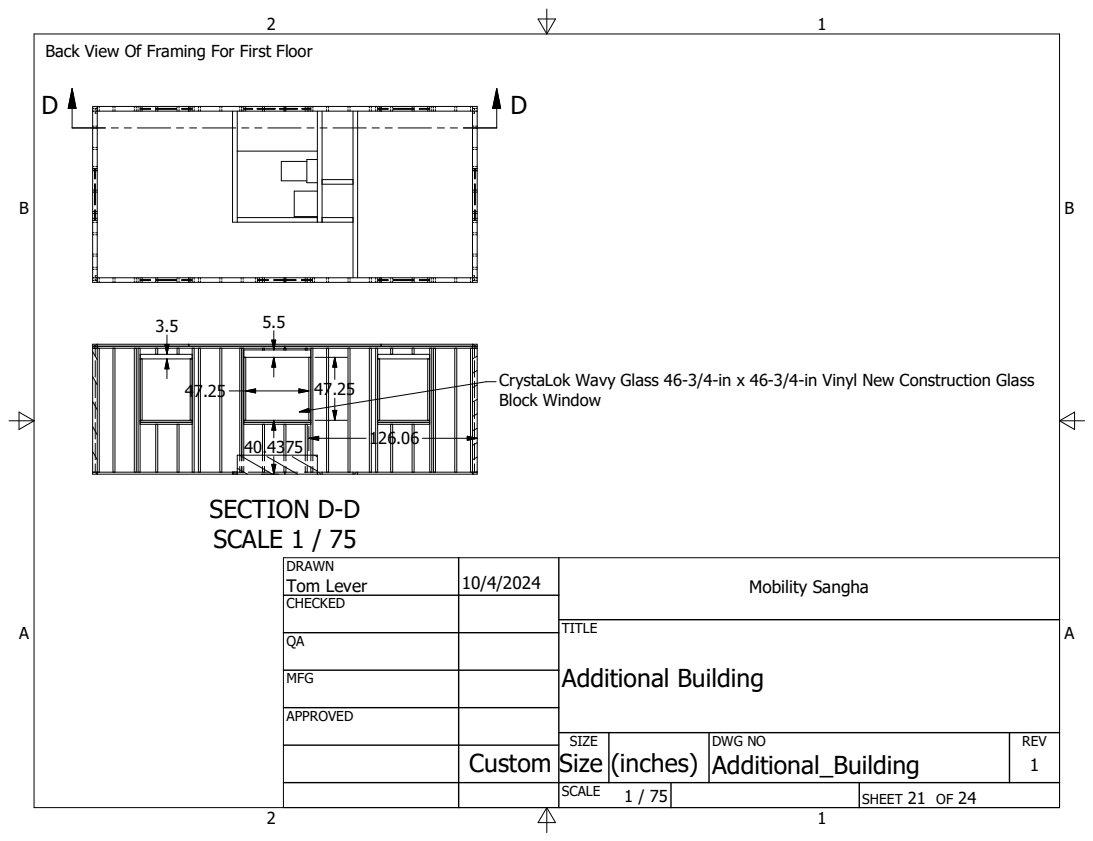
[picture p25: page 21]
SECTION D-D SCALE 1 / 75; SHEET 21 OF 24; DWG NO Additional_Building; TITLE Additional Building; SIZE; REV 1

Back View Of Framing For First Floor

CrystaLok Wavy Glass 46-3/4-in x 46-3/4-in Vinyl New Construction Glass
Block Window

DRAWN Tom Lever | 10/4/2024 | Mobility Sangha

CHECKED

MFG

APPROVED

Custom Size (inches)

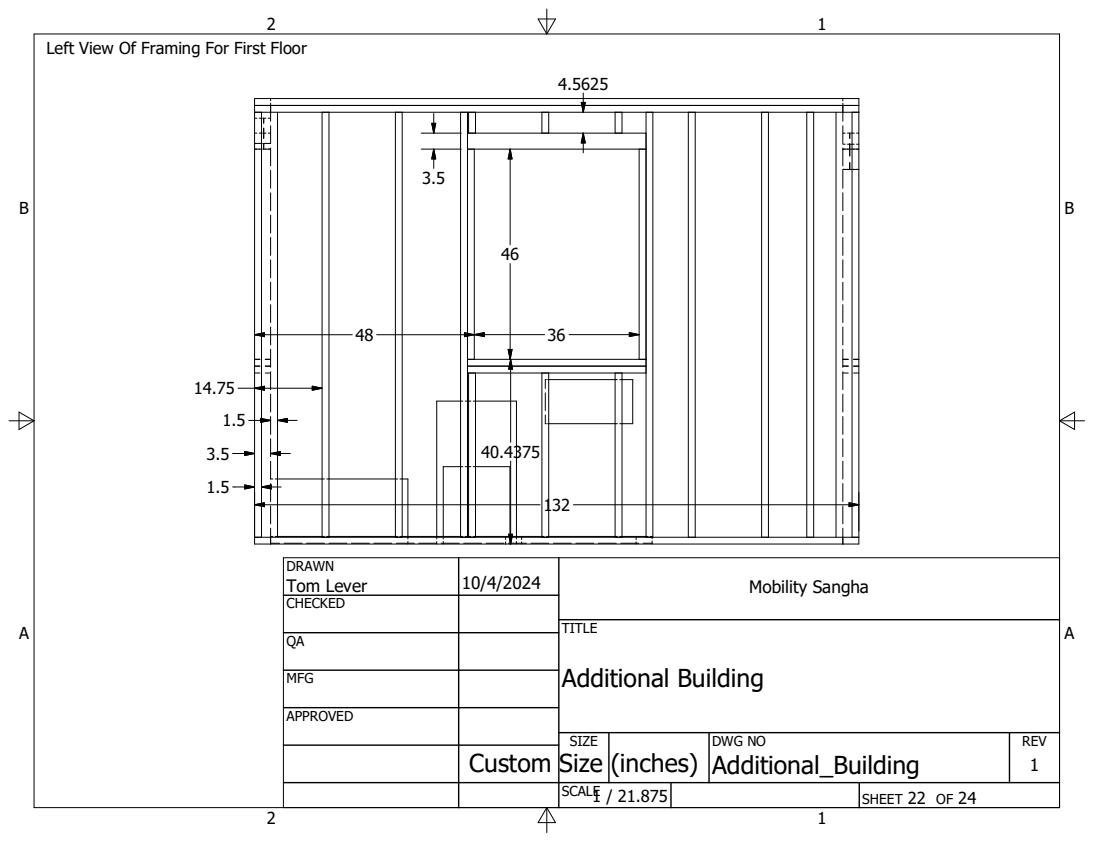
[picture p26: page 22]
SHEET 22 OF 24; DWG NO Additional_Building; TITLE Additional Building; SIZE; REV 1

Left View Of Framing For First Floor

DRAWN Tom Lever | 10/4/2024 | Mobility Sangha

CHECKED

MFG

APPROVED

Custom Size (inches)

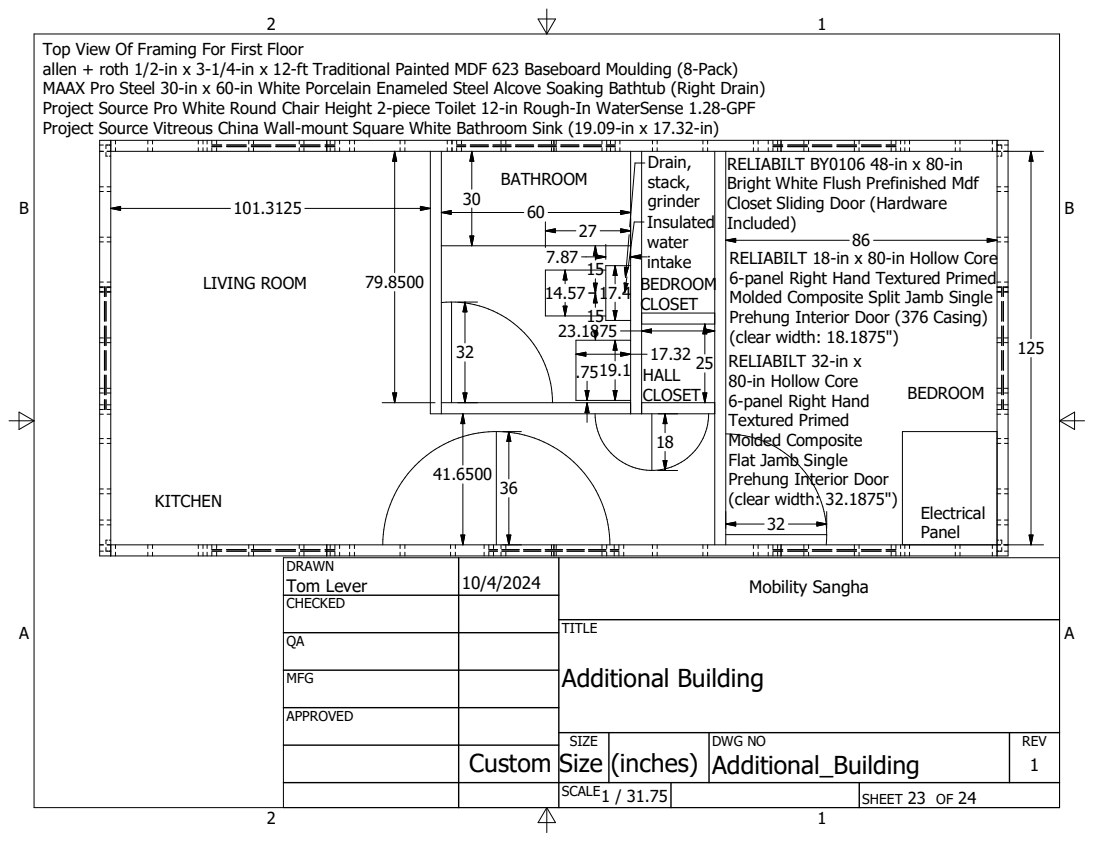
[picture p27: page 23]
SHEET 23 OF 24; DWG NO Additional_Building; TITLE Additional Building; SIZE; REV 1; BEDROOM; BEDROOM CLOSET; LIVING ROOM; KITCHEN; BATHROOM; (clear width: 18.1875"); Electrical Panel; Insulated water intake; Drain, stack, grinder

Top View Of Framing For First Floor
allen + roth 1/2-in x 3-1/4-in x 12-ft Traditional Painted MDF 623 Baseboard Moulding (8-Pack)
MAAX Pro Steel 30-in x 60-in White Porcelain Enameled Steel Alcove Soaking Bathtub (Right Drain)
Project Source Pro White Round Chair Height 2-piece Toilet 12-in Rough-In WaterSense 1.28-GPF
Project Source Vitreous China Wall-mount Square White Bathroom Sink (19.09-in x 17.32-in)

RELIABILT BY0106 48-in x 80-in
Bright White Flush Prefinished Mdf
Closet Sliding Door (Hardware
Included)
RELIABILT 18-in x 80-in Hollow Core
6-panel Right Hand Textured Primed
Molded Composite Split Jamb Single
Prehung Interior Door (376 Casing)
RELIABILT 32-in x
HALL
CLOSET

80-in Hollow Core
6-panel Right Hand
Textured Primed
Molded Composite
Flat Jamb Single
Prehung Interior Door
(clear width: 32.1875")

DRAWN Tom Lever | 10/4/2024 | Mobility Sangha

CHECKED

MFG

APPROVED

Custom Size (inches)

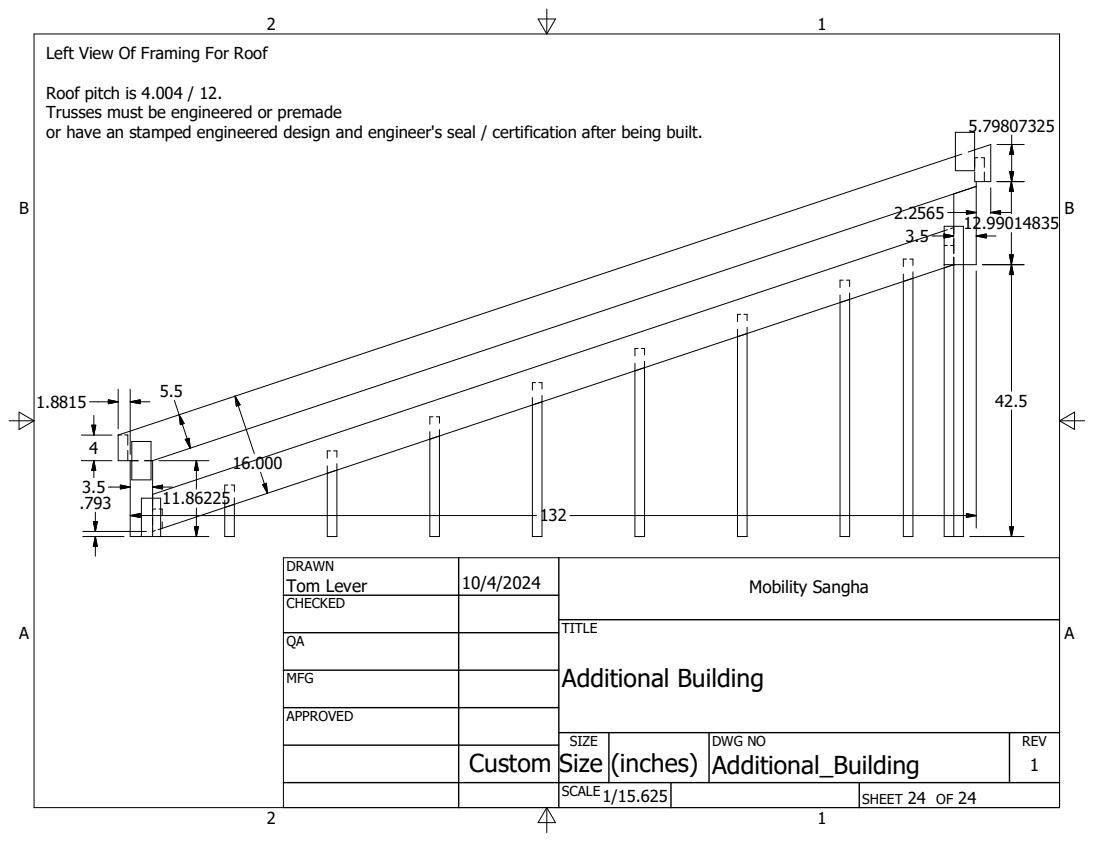
[picture p28: page 24]
SHEET 24 OF 24; DWG NO Additional_Building; TITLE Additional Building; SIZE; REV 1

Left View Of Framing For Roof

Roof pitch is 4.004 / 12.
Trusses must be engineered or premade
or have an stamped engineered design and engineer's seal / certification after being built.

DRAWN Tom Lever | 10/4/2024 | Mobility Sangha

CHECKED

MFG

APPROVED

Custom Size (inches)
