tslever/Inventor/Mobility/Additional_Building/Front_View_Of_Bathtub.png

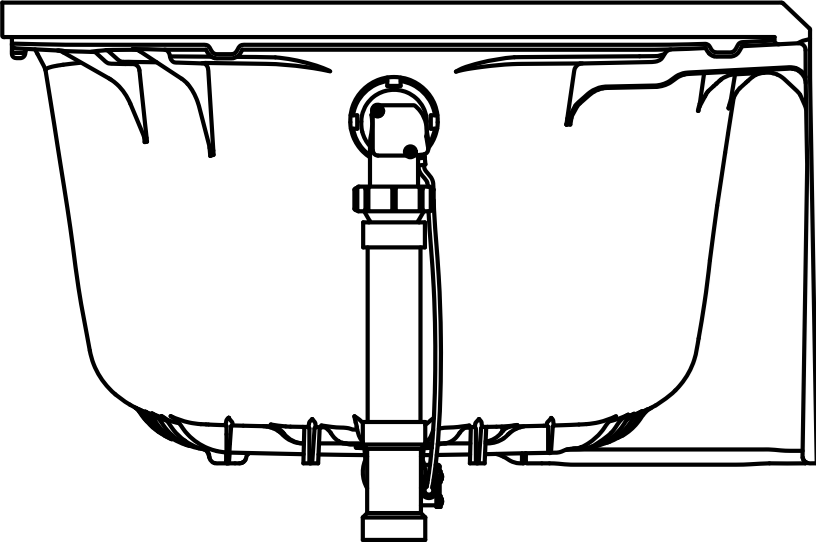
Mobility/Additional_Building/Front_View_Of_Bathtub.png
