tslever/Inventor/Mobility/Additional_Building/Plat.pdf

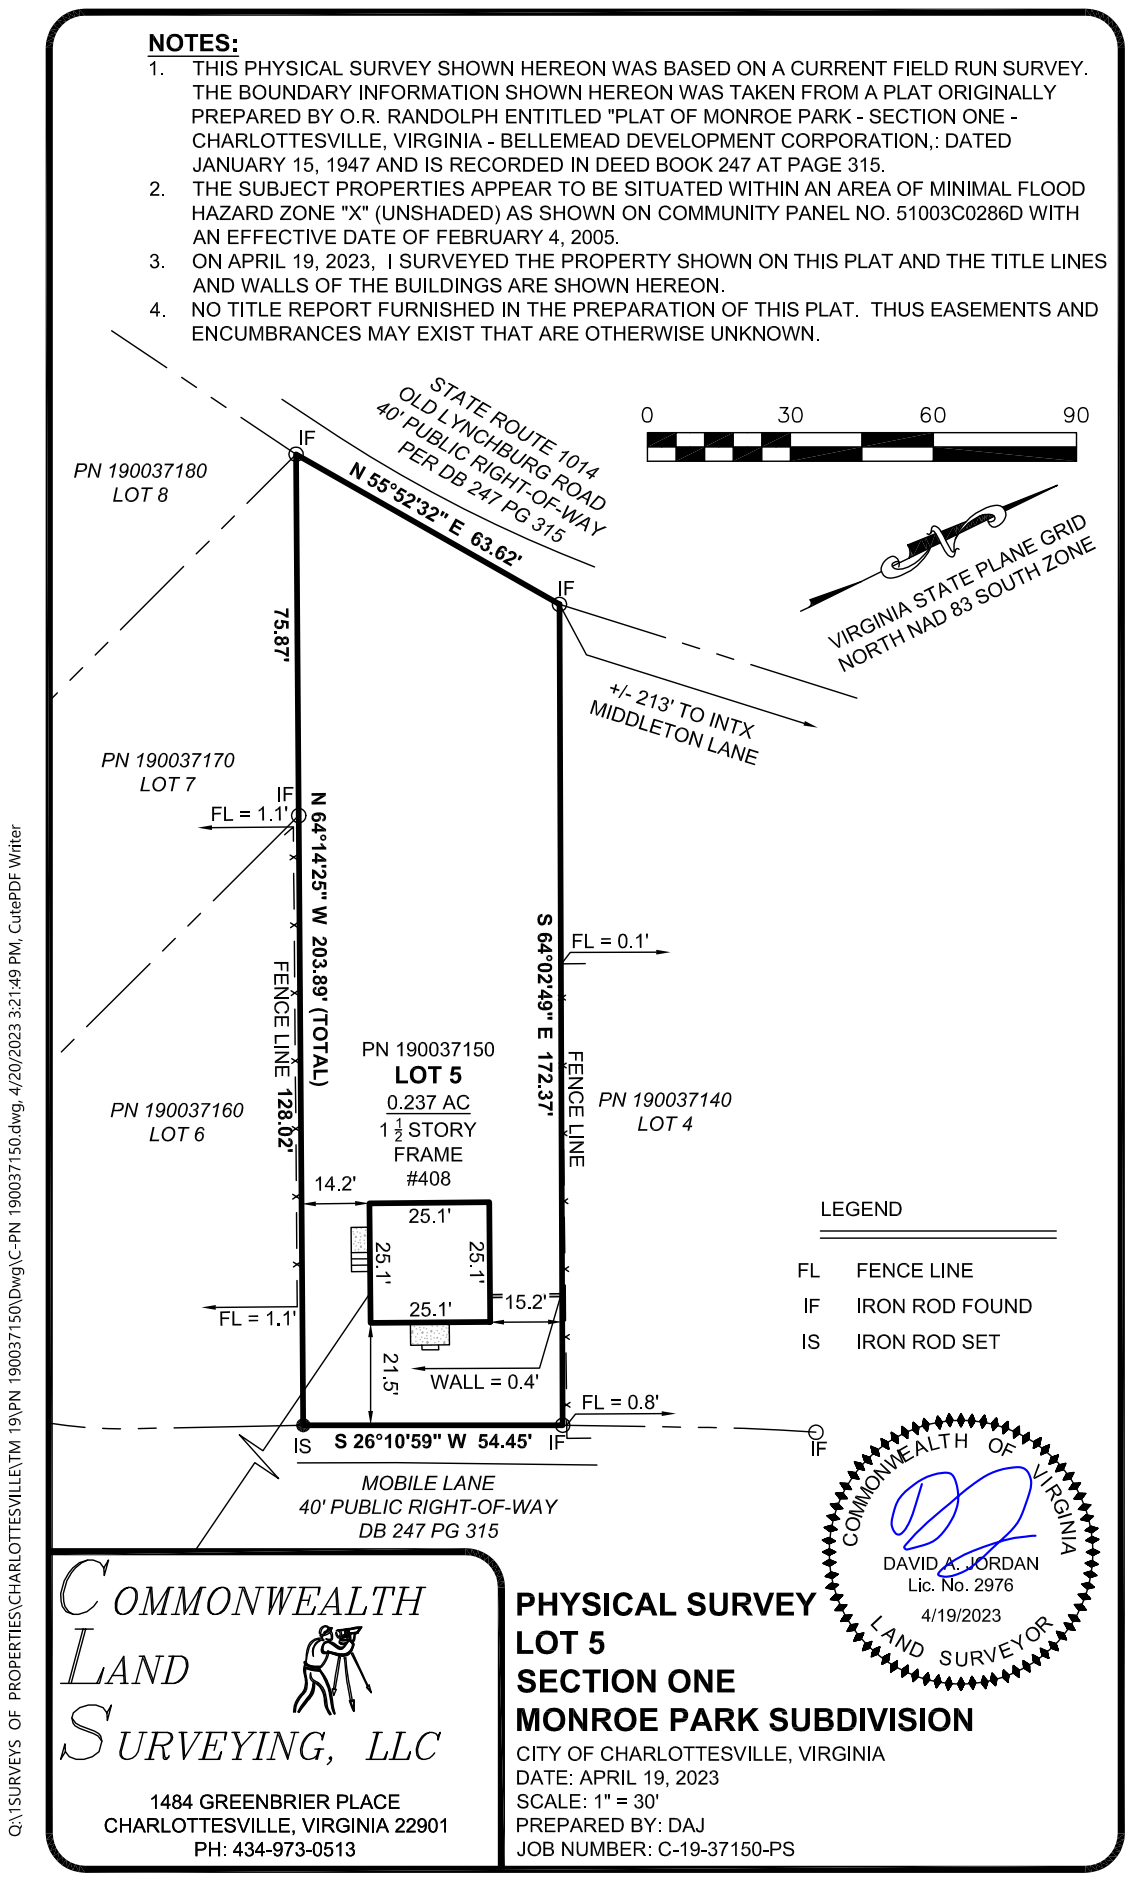
[picture p30: page 1]
