tslever/Inventor/Mobility/Existing_House.pdf

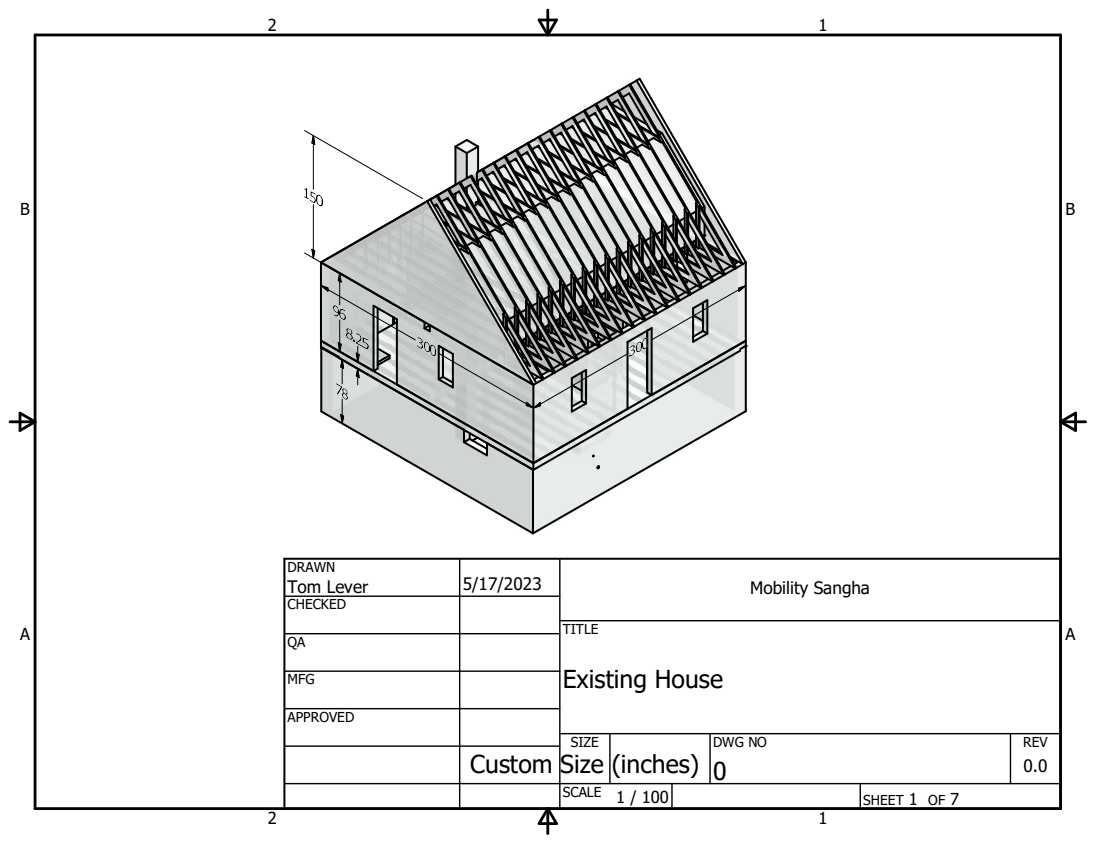
[picture p31: page 1]
SHEET 1 OF 7; DWG NO 0; TITLE Existing House; SIZE; SCALE; REV 0.0

DRAWN Tom Lever | 5/17/2023 | Mobility Sangha

CHECKED

MFG

APPROVED

Custom Size (inches)

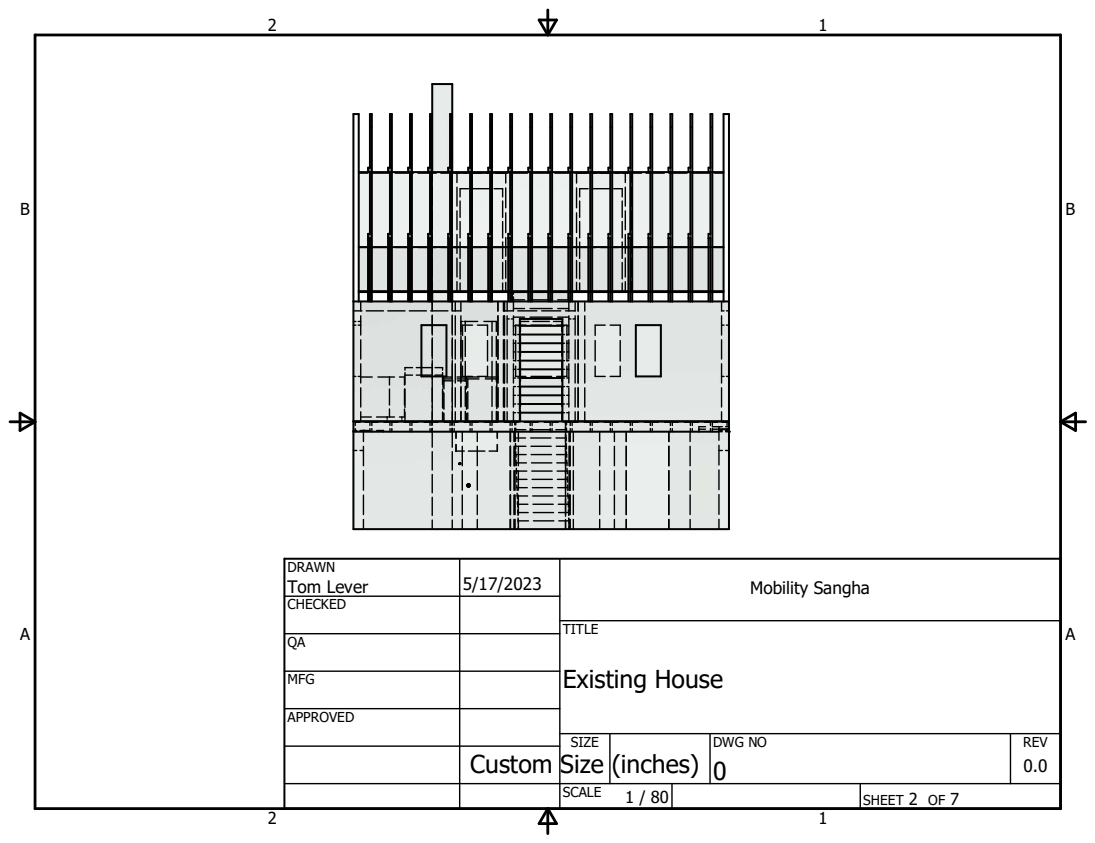
[picture p32: page 2]
SHEET 2 OF 7; DWG NO 0; TITLE Existing House; SIZE; REV 0.0

DRAWN Tom Lever | 5/17/2023 | Mobility Sangha

CHECKED

MFG

APPROVED

Custom Size (inches)

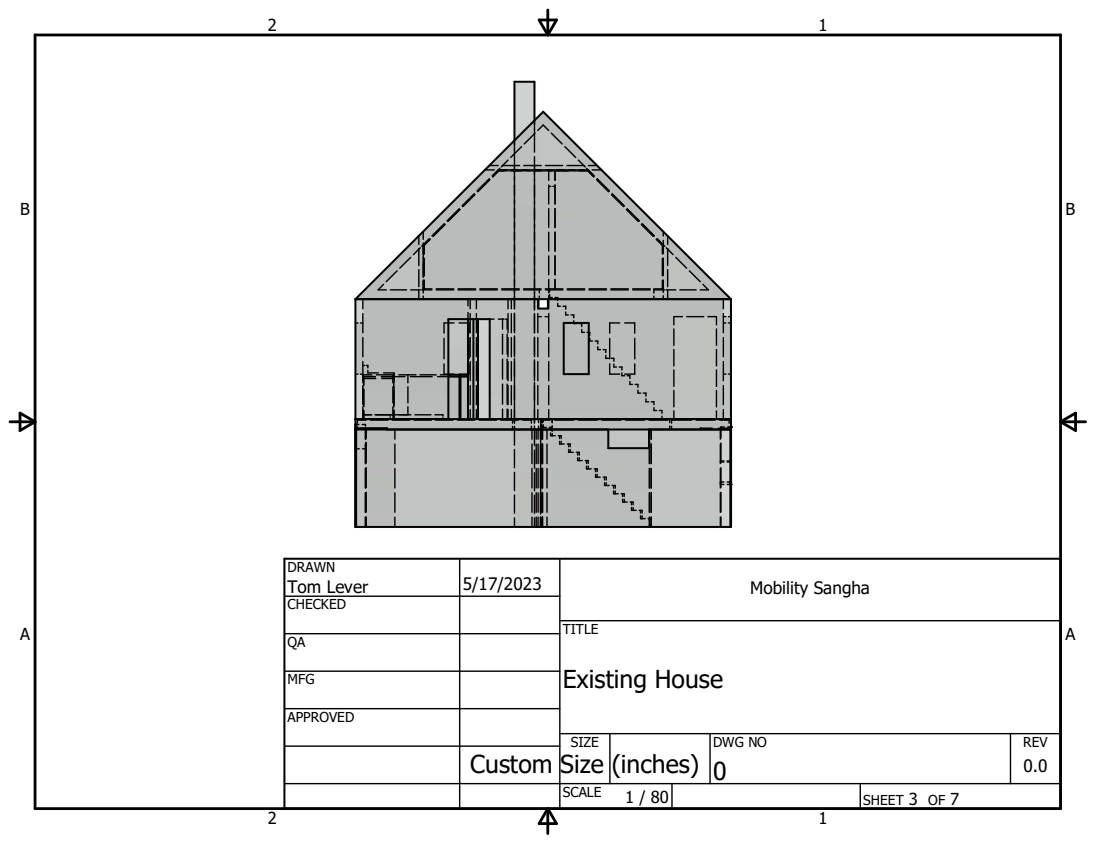
[picture p33: page 3]
SHEET 3 OF 7; DWG NO 0; TITLE Existing House; SIZE; REV 0.0

DRAWN Tom Lever | 5/17/2023 | Mobility Sangha

CHECKED

MFG

APPROVED

Custom Size (inches)

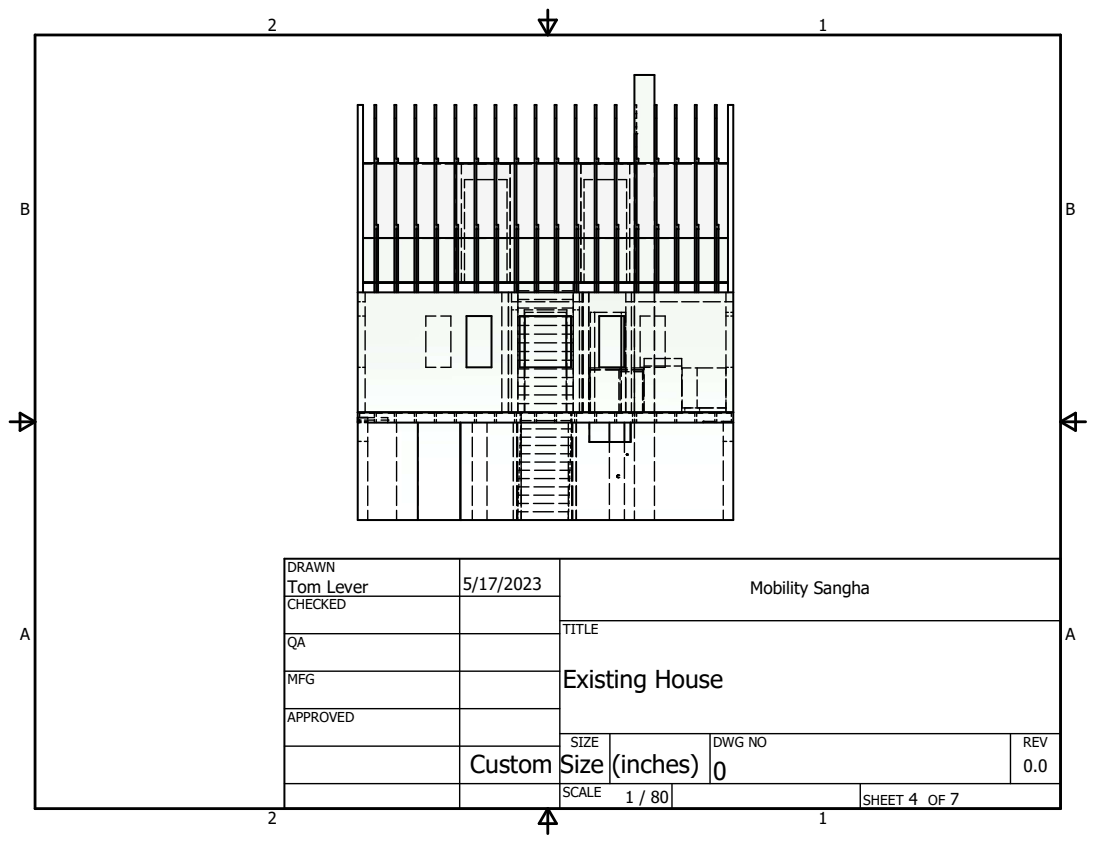
[picture p34: page 4]
SHEET 4 OF 7; DWG NO 0; TITLE Existing House; SIZE; REV 0.0

DRAWN Tom Lever | 5/17/2023 | Mobility Sangha

CHECKED

MFG

APPROVED

Custom Size (inches)

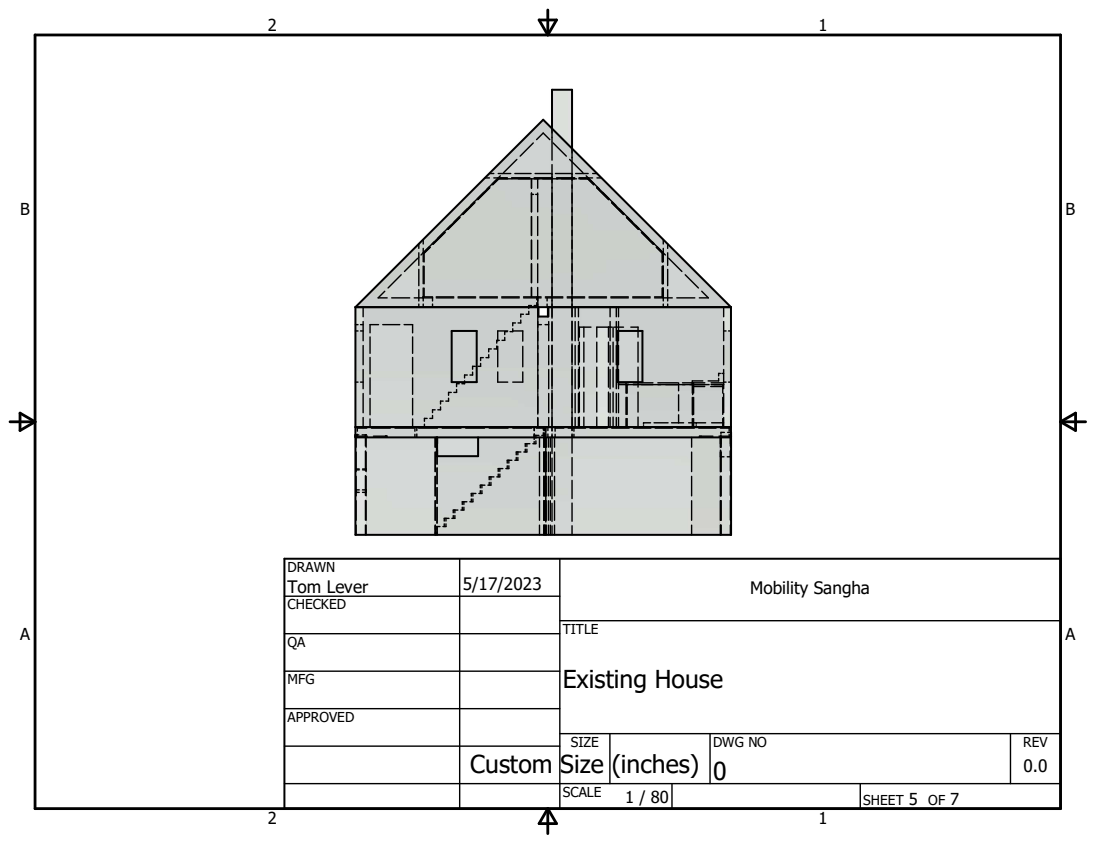
[picture p35: page 5]
SHEET 5 OF 7; DWG NO 0; TITLE Existing House; SIZE; REV 0.0

DRAWN Tom Lever | 5/17/2023 | Mobility Sangha

CHECKED

MFG

APPROVED

Custom Size (inches)

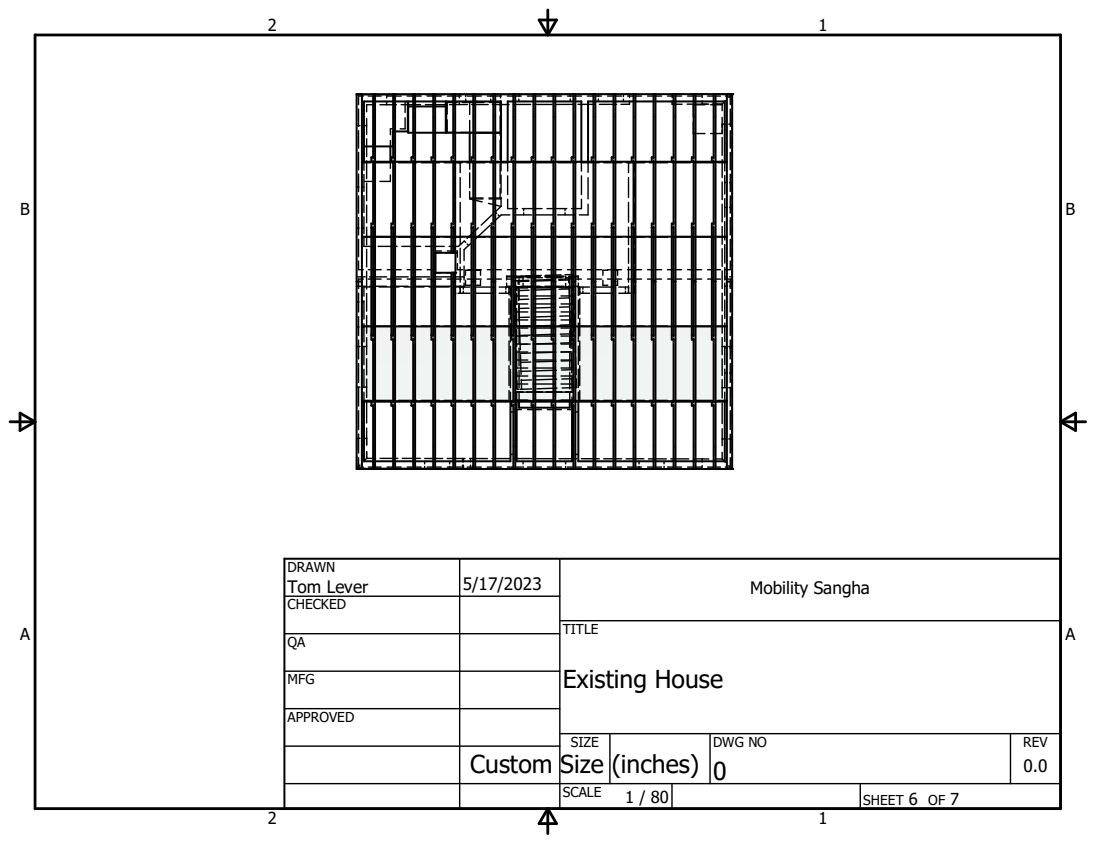
[picture p36: page 6]
SHEET 6 OF 7; DWG NO 0; TITLE Existing House; SIZE; REV 0.0

DRAWN Tom Lever | 5/17/2023 | Mobility Sangha

CHECKED

MFG

APPROVED

Custom Size (inches)

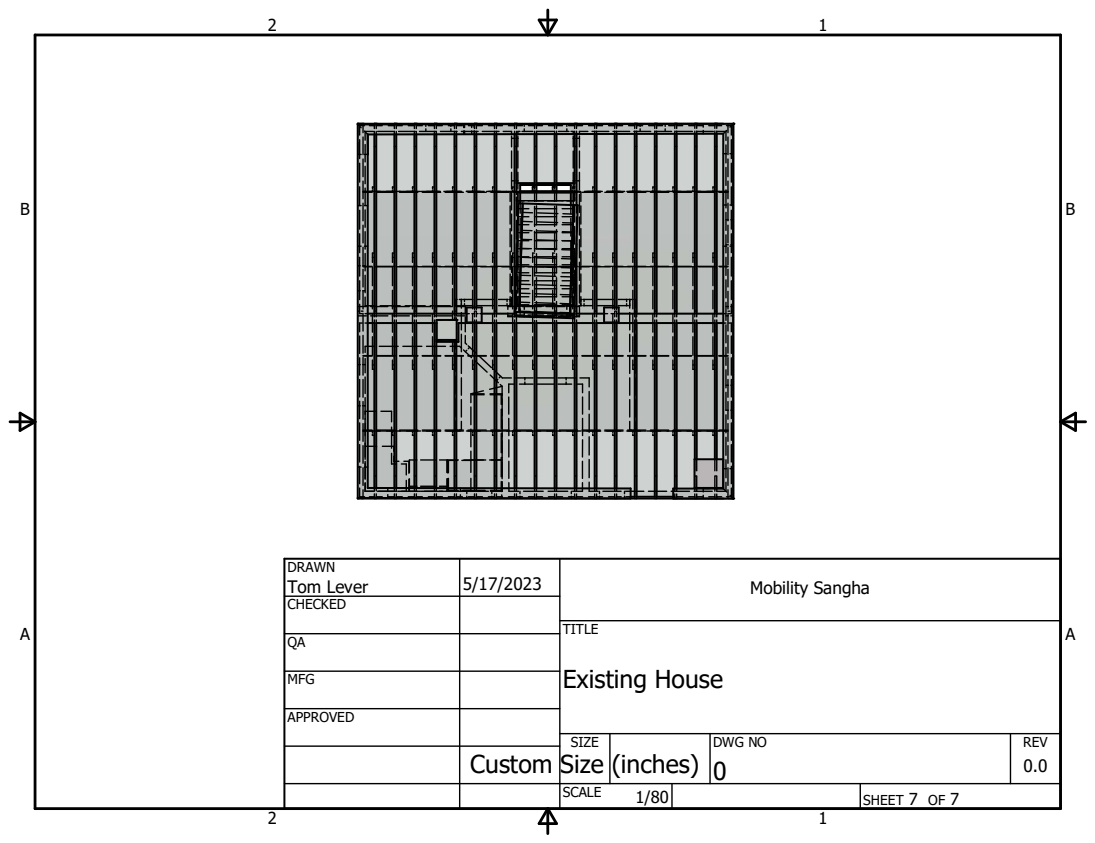
[picture p37: page 7]
SHEET 7 OF 7; DWG NO 0; TITLE Existing House; SIZE; REV 0.0

DRAWN Tom Lever | 5/17/2023 | Mobility Sangha

CHECKED

MFG

APPROVED

Custom Size (inches)
