tslever/Inventor/Mobility/Replumbing_Mobility.pdf

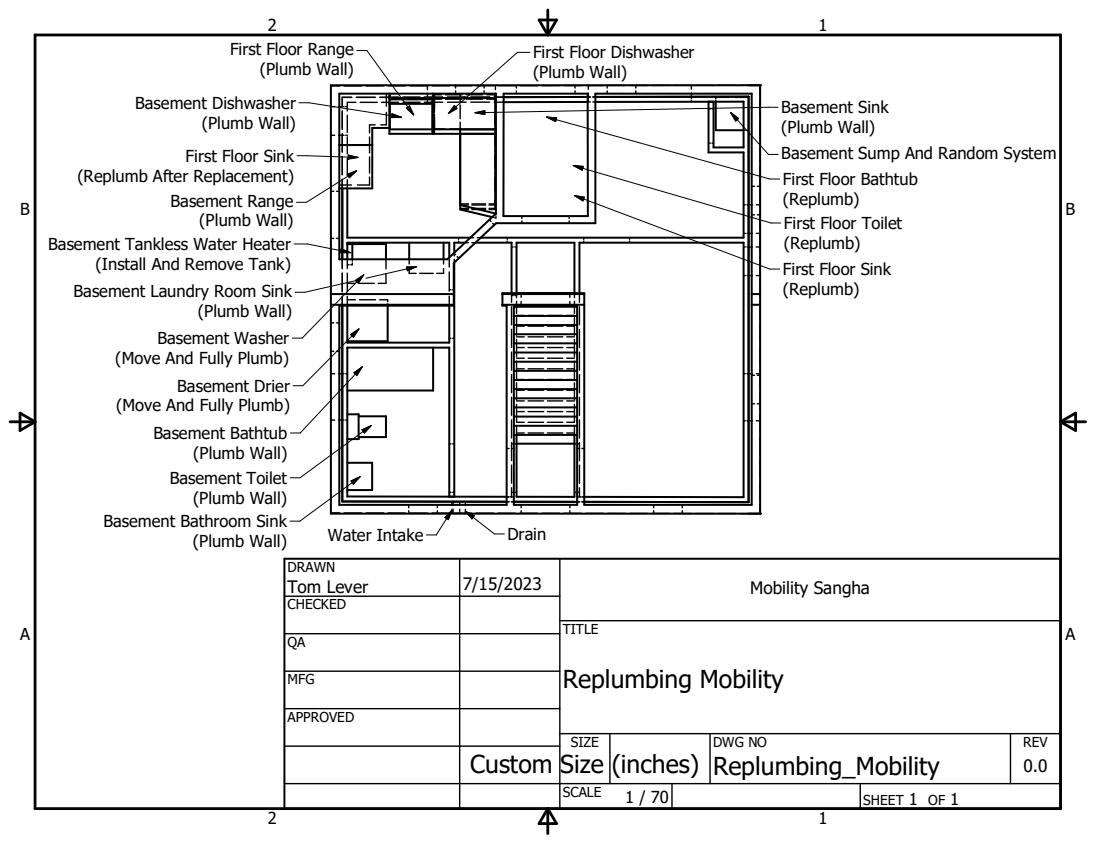
[picture p38: page 1]
SHEET 1 OF 1; DWG NO Replumbing_Mobility; TITLE Replumbing Mobility; SIZE; SCALE; REV 0.0; Water Intake; Drain; (Plumb Wall); Basement Drier; Basement Range (Plumb Wall); Basement Dishwasher

First Floor Range
(Plumb Wall)

First Floor Dishwasher

Basement Sink
Basement Sump And Random System
First Floor Bathtub
(Replumb)
First Floor Toilet
First Floor Sink

(Replumb After Replacement)
Basement Tankless Water Heater
(Install And Remove Tank)
Basement Laundry Room Sink

Basement Washer
(Move And Fully Plumb)

Basement Bathtub
Basement Toilet

Basement Bathroom Sink

DRAWN Tom Lever | 7/15/2023 | Mobility Sangha

CHECKED

MFG

APPROVED

Custom Size (inches)
