tslever/Inventor/Mobility/Attic/Existing_Attic.pdf

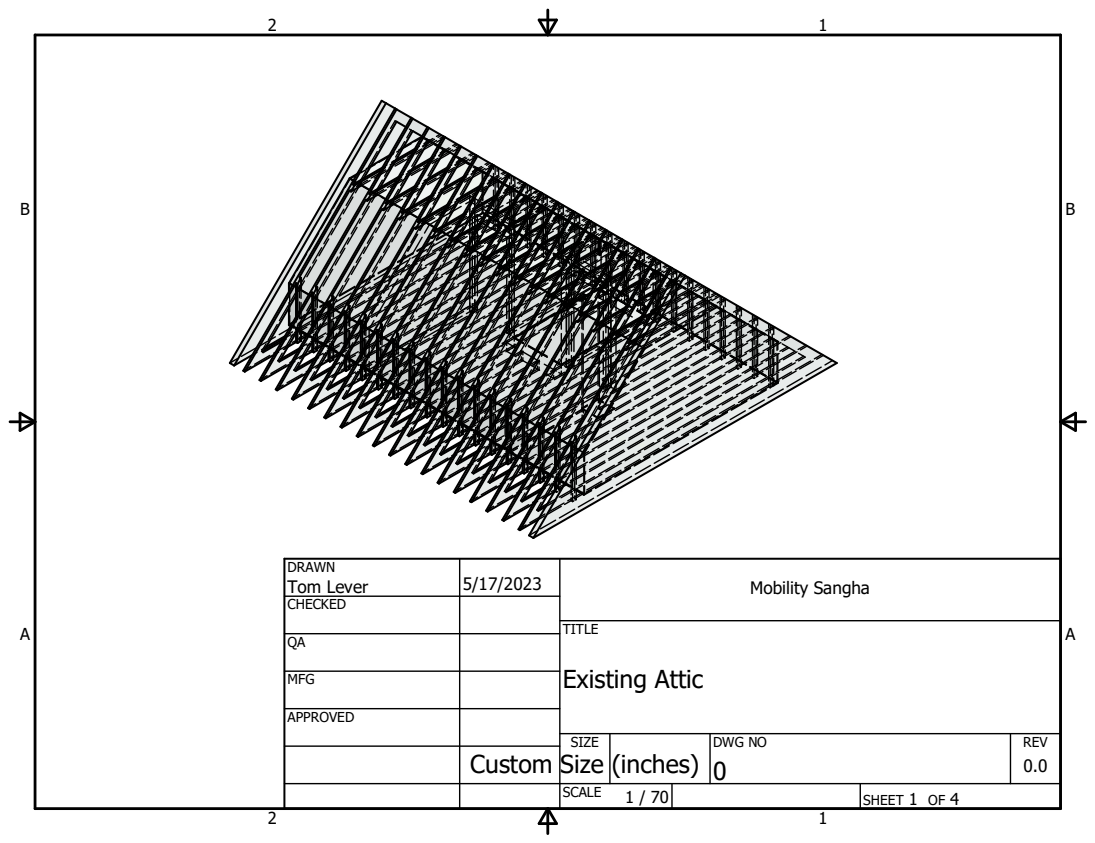
[picture p39: page 1]
SHEET 1 OF 4; DWG NO 0; TITLE Existing Attic; SIZE; SCALE; REV 0.0

DRAWN Tom Lever | 5/17/2023 | Mobility Sangha

CHECKED

MFG

APPROVED

Custom Size (inches)

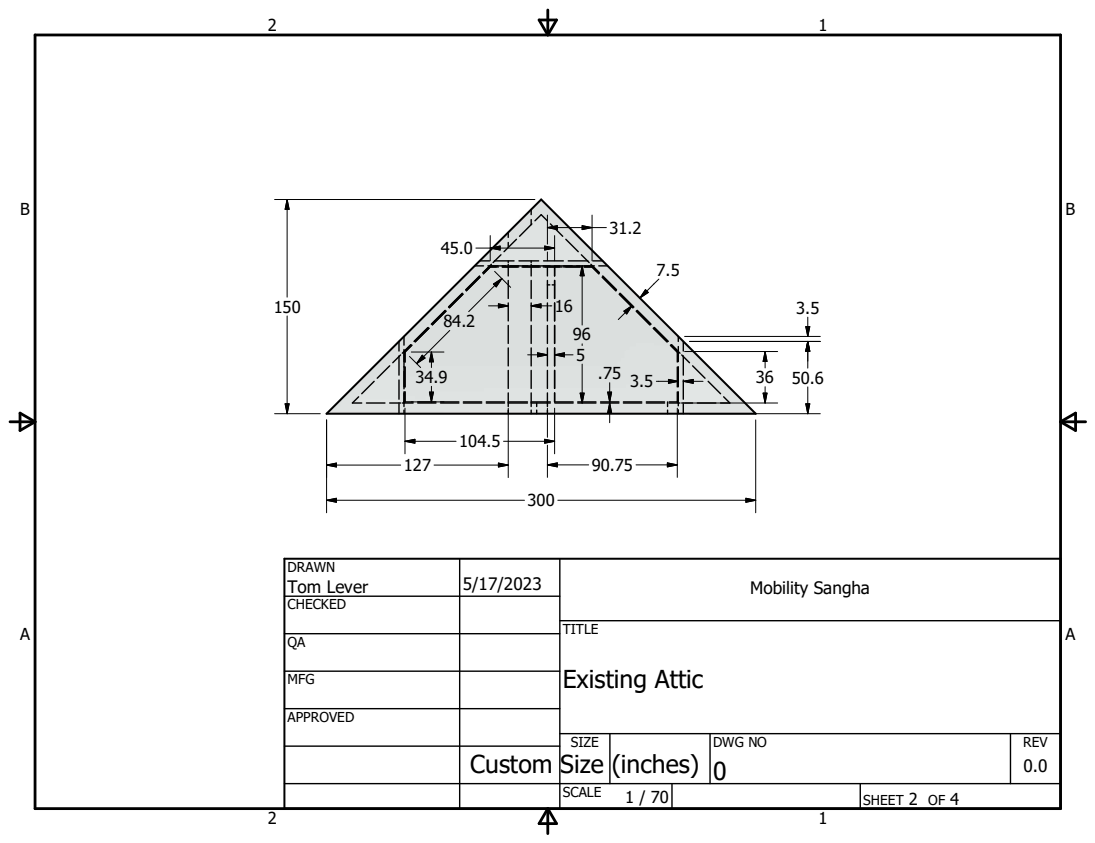
[picture p40: page 2]
SHEET 2 OF 4; DWG NO 0; TITLE Existing Attic; SIZE; REV 0.0

DRAWN Tom Lever | 5/17/2023 | Mobility Sangha

CHECKED

MFG

APPROVED

Custom Size (inches)

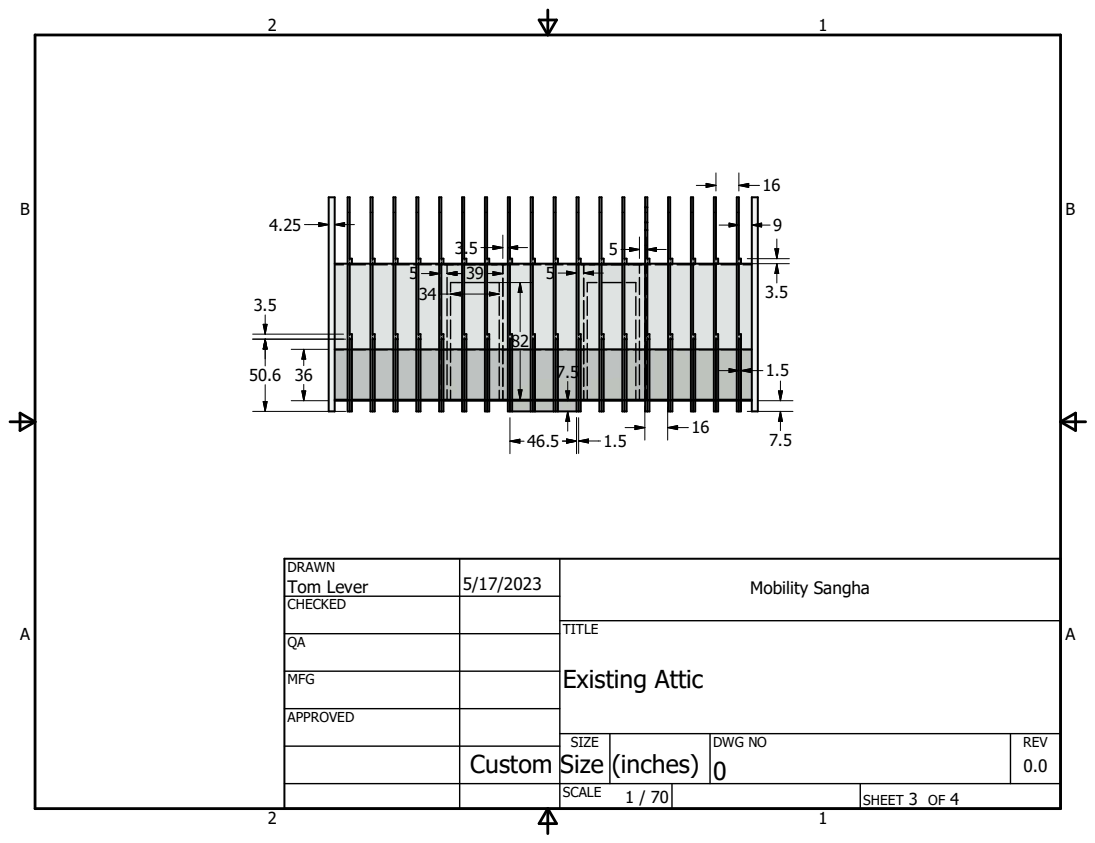
[picture p41: page 3]
SHEET 3 OF 4; DWG NO 0; TITLE Existing Attic; SIZE; REV 0.0

DRAWN Tom Lever | 5/17/2023 | Mobility Sangha

CHECKED

MFG

APPROVED

Custom Size (inches)

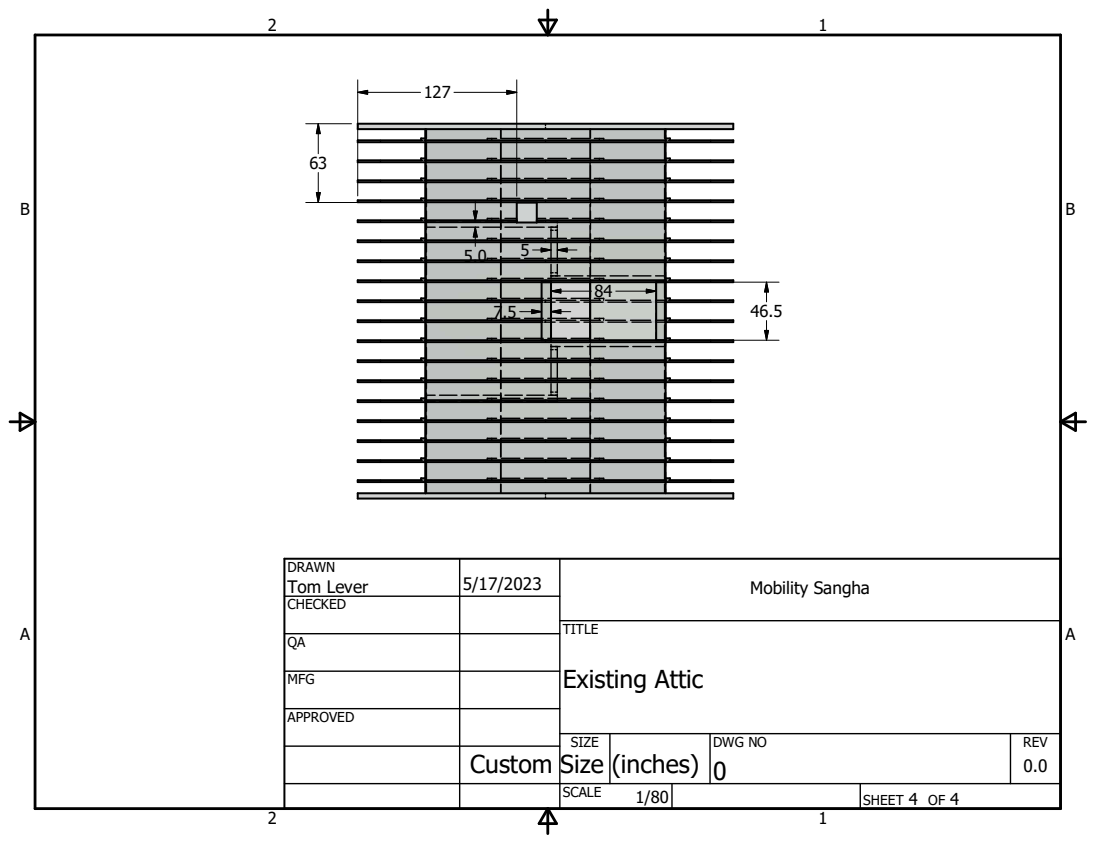
[picture p42: page 4]
SHEET 4 OF 4; DWG NO 0; TITLE Existing Attic; SIZE; REV 0.0

DRAWN Tom Lever | 5/17/2023 | Mobility Sangha

CHECKED

MFG

APPROVED

Custom Size (inches)
