tslever/Inventor/(commit log)

2024-05-16 Added Mobility
    [Bathroom_Sink.ipt, Bathtub.ipt, Beam--7.5_x_7.5_x_300.ipt, Beam--7.5_x_7.5_x_46.5.ipt, Butcher_Block--1.5_x_25_x_43.75_in.ipt, Chimney.ipt, Corner_Cabinet.ipt, Dishwasher.ipt]
2024-05-16 Added Music and Tiny-House_Trailer
    [Angle--Anterior--Left.ipt, Angle--Anterior--Right.ipt, Angle--Posterior--Left.ipt, Angle--Posterior--Right.ipt, Base_for_Frets.ipt, Beam--1x3.ipt, Beam--2x2.ipt, Beam--Front_and_Back.ipt]
2024-08-03 Added Shed Area
    [Earth_Extending_NW_From_N_Edge_Of_Foundation_Where_Foundation_Meets_Ground.ipt, Footer.ipt, Foundation_Wall.ipt, Shed_Area.dwg, Shed_Area.iam, Slab_Of_House.ipt]
2024-08-08 Added maple tree
    [Earth_Extending_NW_From_N_Edge_Of_Foundation_Where_Foundation_Meets_Ground.ipt, Maple_Tree.ipt, Shed_Area.iam]
2024-08-08 Reorganized directory Additional Building
    [Area_For_Additional_Building_With_Foundation_Wall_For_Additional_Building.dwg, Area_For_Additional_Building_With_Foundation_Wall_For_Additional_Building.iam, Earth_For_Foundation_Wall_For_Additional_Building.ipt, Footer_For_Additional_Building.ipt, Foundation_Wall_For_Additional_Building.ipt, Maple_Tree.ipt, Shed_Area.dwg, Shed_Area.iam]
2024-08-08 Added Area_For_Additional_Building_With_Piers
    [Area_For_Additional_Building_With_Foundation_Wall_For_Additional_Building.dwg, Area_For_Additional_Building_With_Foundation_Wall_For_Additional_Building.iam, Earth_For_Foundation_Wall_For_Additional_Building.ipt]
2024-08-08 Added area for additional building with piers
    [Area_For_Additional_Building_With_Foundation_Wall_For_Additional_Building.dwg, Area_For_Additional_Building_With_Foundation_Wall_For_Additional_Building.iam, Area_For_Additional_Building_With_Piers.dwg, Area_For_Additional_Building_With_Piers.iam, Earth.ipt, Grid_Of_Piers.iam, Pier.ipt]
2024-08-16 Added dimensions to area for additional building with piers
    [Area_For_Additional_Building_With_Piers.dwg, Grid_Of_Piers.iam]
2024-08-17 Added sheet for painting outside of bathroom and in living room
    [Finished_First_Floor.dwg]
2024-08-17 Swapped long beams and short beams
    [Tiny_House_Trailer.iam]
2024-09-09 Completed layout of foundation of additional building
    [Area_For_Additional_Building_With_Piers.dwg, Area_For_Additional_Building_With_Piers.iam, Cage.iam, Grid_Of_Piers.iam, Pier.ipt, Rebar_With_Length_Of_34_Inches.ipt, Ring_Of_Rebar.ipt]
2024-09-14 Used saddle brackets instead of anchor bolts and shortened additional building to accommodate 12 foot beams
    [Area_For_Additional_Building_With_Piers.dwg, Area_For_Additional_Building_With_Piers.iam, Grid_Of_Piers.iam]
2024-09-15 Added squares of underlayment and saddle brackets to piers
    [Area_For_Additional_Building_With_Piers.dwg, Area_For_Additional_Building_With_Piers.iam, Grid_Of_Piers.iam, Pier.iam, Saddle_Bracket.ipt, Saddle_Bracket_MIR.ipt, Saddle_Bracket_MIR1.ipt, Saddle_Bracket_MIR2.ipt]
2024-09-16 Built up to and including subfloor flush with house slab
    [Area_For_Additional_Building_With_Piers.iam, Beam.iam, Beam.ipt, Floor_System.iam, Grid_Of_Piers.iam, Joist_With_Length_144_Inches.iam, Joist_With_Length_144_Inches.ipt, Joist_With_Length_56.5625_Inches.iam]
2024-09-16 Separated additional building from area
    [Additional_Building.iam, Area_For_Additional_Building_With_Foundation_Wall_For_Additional_Building.dwg, Area_For_Additional_Building_With_Foundation_Wall_For_Additional_Building.iam, Area_For_Additional_Building_With_Piers.dwg, Area_For_Additional_Building_With_Piers.iam, Area_With_Additional_Building.iam, Earth.ipt, Earth_For_Foundation_Wall_For_Additional_Building.ipt]
2024-09-16 Designed walls without upper top plate and rafter
    [Additional_Building.iam, Area_With_Additional_Building.iam, Bottom_Plate_With_Length_121_Inches.ipt, Bottom_Plate_With_Length_144_Inches.ipt, California_Corner.iam, California_Corner_MIR.iam, California_Corner_MIR1.iam, California_Corner_MIR_MIR.iam]
2024-09-16 Added upper top plate
    [Additional_Building.iam, Plate_With_Length_121_Inches.ipt, Plate_With_Length_132_Inches.ipt, Plate_With_Length_144_Inches.ipt, Plate_With_Length_66.5_Inches.ipt, Plate_With_Length_72_Inches.ipt, Walls.iam]
2024-09-17 Made height from seat of rafter to seat an even 42.5 inches
    [Rafter.ipt]
2024-09-17 Created labeled drawing of parts of additional building
    [Additional_Building.iam, Area_With_Additional_Building.dwg, Area_With_Additional_Building.iam, Block_With_Width_21.75_Inches.ipt, Block_With_Width_22.5_Inches.ipt, California_Corner.iam, California_Corner_MIR.iam, California_Corner_MIR1.iam]
2024-09-20 Avoided mirroring. Detailed subfloor. Used 2x4s spaced 16" on center. Deepened trusses. Used OSB and DensGlass.
    [Additional_Building.iam, Block_With_Width_13.75_Inches.ipt, Block_With_Width_14.5_Inches.ipt, Block_With_Width_21.75_Inches.ipt, Block_With_Width_22.5_Inches.ipt, California_Corner.iam, California_Corner_MIR.iam, California_Corner_MIR1.iam]
2024-09-20 Completed siding on NE side of additional building
    [Additional_Building.iam, Fascia.ipt, Fiber_Cement_Board.ipt, Fiber_Cement_Board_With_Height_3.954_Inches.ipt, Rafter.ipt, Siding.iam, Starter_Strip.ipt, Truss.iam]
2024-09-20 Developed preliminary drawings for additional building
    [Additional_Building.iam, Area_With_Additional_Building.dwg, Area_With_Additional_Building.iam, Fiber_Cement_Board_For_Back_Wall.ipt, Fiber_Cement_Board_For_Side_Wall.ipt, Floor_System.iam, Grid_Of_Piers.iam, OSB_For_Side_And_Back.ipt]
2024-09-20 Changed water, drain, and electrical
    [Additional_Building.iam, Area_With_Additional_Building.dwg, Area_With_Additional_Building.iam, Floor_System.iam, Grid_Of_Piers.iam, Plate_With_Length_86.5625_Inches_And_Image_Of_Bath_Tub.ipt, Walls.iam]
2024-09-21 Added branch to maple tree and moved additional building downhill
    [Area_With_Additional_Building.dwg, Area_With_Additional_Building.iam, Maple_Tree.ipt]
2024-09-30 Added sheathing and studs and supports for ceiling
    [Additional_Building.iam, Block_With_Width_13.75_Inches.ipt, Block_With_Width_14.5_Inches.ipt, OSB_For_Roof_With_Dimensions_45.796_x_48.ipt, OSB_For_Roof_With_Dimensions_48_x_48.ipt, OSB_For_Walls_With_Dimensions_36.5_x_96_Inches.ipt, OSB_For_Walls_With_Dimensions_37_x_96_Inches.ipt, Plate_With_Length_86.5625_Inches_And_Image_Of_Bath_Tub.ipt]
2024-09-30 Sheathed side
    [Additional_Building.iam, OSB_For_Side_And_Back.ipt, OSB_For_Side_And_Middle.ipt, OSB_For_Side_And_Top.ipt, Truss.iam]
2024-10-01 Added drip edge
    [Additional_Building.iam, Drip_Edge_For_Back.ipt, Drip_Edge_For_Front.ipt, Fascia.ipt, Fascia_For_Back.ipt, Fascia_For_Front.ipt, Fascia_For_Side.ipt, Fiber_Cement_Board_For_Side_Wall.ipt]
2024-10-02 Added underlayment to walls and side drip edge
    [Additional_Building.iam, Area_With_Additional_Building.iam, Drip_Edge_For_Side.ipt, Fascia_For_Back.ipt, Fascia_For_Side.ipt, OSB_For_Rear_Roof.ipt, OSB_For_Roof_With_Dimensions_46.416_x_96.ipt, OSB_For_Roof_With_Dimensions_46.791_x_96.ipt]
2024-10-03 Finished rough draft of building without openings
    [Additional_Building.iam, Area_With_Additional_Building.dwg, Area_With_Additional_Building.iam, Bottom_Of_End_Cap_Of_Intake_Vent.ipt, Drip_Edge_For_Back.ipt, Drip_Edge_For_Front.ipt, Drip_Edge_For_Side.ipt, Fascia_For_Back.ipt]
2024-10-04 Created Additional Building Version 2 through first starter shingles
    [Additional_Building.iam, Additional_Building_Version_2.iam, Area_With_Additional_Building.dwg, Area_With_Additional_Building.iam, DensGlass.iam, DensGlass_With_Dimensions_12_x_60.75_Inches.ipt, DensGlass_With_Dimensions_25.5_x_36.5_Inches.ipt, Drip_Edge_For_Back.ipt]
2024-10-04 Added starter shingles
    [Additional_Building_Version_2.iam, Starter_Shingle_With_Dimensions_6.5_x_25.763_Inches.ipt, Starter_Shingle_With_Dimensions_6.5_x_27.863_Inches.ipt, Starter_Shingle_With_Dimensions_6.5_x_28.25_Inches.ipt, Starter_Shingle_With_Dimensions_6.5_x_30.988_Inches.ipt, Starter_Shingle_With_Dimensions_6.5_x_32.013_Inches.ipt, Starter_Shingle_With_Dimensions_6.5_x_32.075_Inches.ipt, Starter_Shingle_With_Di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]
2024-10-04 Aligned starter shingles flush with interior edge of drip edge
    [Additional_Building_Version_2.iam, Starter_Shingle_With_Dimensions_6.5_x_25.263_Inches.ipt, Starter_Shingle_With_Dimensions_6.5_x_25.763_Inches.ipt, Starter_Shingle_With_Dimensions_6.5_x_30.363_Inches.ipt, Starter_Shingle_With_Dimensions_6.5_x_30.988_Inches.ipt, Starter_Shingle_With_Dimensions_6.5_x_31.763_Inches.ipt, Starter_Shingle_With_Dimensions_6.5_x_32.263_Inches.ipt, Starter_Shingle_With_D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]
2024-10-05 Drew Additional Building
    [Additional_Building.iam, Additional_Building_Version_2.iam, Area_With_Additional_Building.dwg, Area_With_Additional_Building.iam, Cage.iam, Coil_Of_Wire.iam, Coil_Of_Wire.ipt, Earth.ipt]
2024-10-12 Created left view of area of additional building with materials labeled
2024-10-13 Eliminated color from drawings, suppressed tree, removed tubes, including house wrap on back
    [Additional_Building.iam, Area_With_Additional_Building.iam, Beam.ipt, Cage.iam, DensGlass.iam, DensGlass_With_Dimensions_12_x_60.6875_Inches.ipt, DensGlass_With_Dimensions_12_x_60.75_Inches.ipt, DensGlass_With_Dimensions_25.375_x_36.5_Inches.ipt]
2024-10-13 Included housewrap on back
    [Additional_Building.iam]
2024-10-13 Excavated, shortened piers, and updated drawings
    [Additional_Building.iam, Area_With_Additional_Building.iam, Cage.iam, Earth.ipt, Grid_Of_Piers.iam, Pier.iam, Pier.ipt, Rebar_With_Length_Of_33.31275_Inches.ipt]
2024-10-13 Revised drawings as required except for grounding rods and interior
    [Additional_Building.iam, Area_With_Additional_Building.iam, Framing_For_Roof.iam, Grid_Of_Piers.iam, Rafter.ipt, Saddle_Bracket.ipt, Truss.iam]
2024-10-14 Added ground rods
    [Additional_Building.dwg, Additional_Building.iam, Area_With_Additional_Building.iam, Cage.iam, Grid_Of_Piers.iam, Ground_Rod.ipt, Pier.iam, Pier.ipt]
2024-10-14 Added door
    [Additional_Building.dwg, Additional_Building.iam, Area_With_Additional_Building.iam, Cage.iam, Framing_For_First_Floor.iam, Grid_Of_Piers.iam, Header_With_Dimensions_0.5_x_3.5_x_41.25_Inches.ipt, Header_With_Dimensions_1.5_x_3.5_x_41.25_Inches.ipt]
2024-10-20 Added most of window framing
    [Additional_Building.dwg, Additional_Building.iam, Area_With_Additional_Building.iam, Framing_For_First_Floor.iam, Framing_For_First_Floor_Back_Bathroom_Window.iam, Framing_For_First_Floor_Back_Living_Room_Window.iam, Framing_For_First_Floor_Front_Window.iam, Framing_For_First_Floor_Side_Window.iam]
2024-10-20 Framed first floor exterior walls
    [Framing_For_Back_Bedroom_Window.iam, Framing_For_Back_Living_Room_Window.iam, Framing_For_Bathroom_Window.iam, Framing_For_First_Floor.iam, Framing_For_First_Floor_Back_Bathroom_Window.iam, Framing_For_First_Floor_Back_Living_Room_Window.iam, Framing_For_Side_Window.iam]
2024-10-20 Diagramed first floor exterior walls
    [Additional_Building.dwg, Additional_Building.iam, Area_With_Additional_Building.iam]
2024-10-20 Expanded bathroom window and cut holes in sheathing
    [Additional_Building.dwg, Additional_Building.iam, Area_With_Additional_Building.iam, DensGlass.iam, Framing_For_Bathroom_Window.iam, Framing_For_First_Floor.iam, Header_With_Dimensions_0.5_x_3.5_x_50.25_Inches.ipt, Header_With_Dimensions_1.5_x_3.5_x_50.25_Inches.ipt]
2024-10-21 Finished holes for first floor windows
    [Additional_Building.iam, DensGlass.iam, Sheathing_For_Back.iam]
2024-10-21 Made windows symmetric
    [Additional_Building.dwg, Additional_Building.iam, Area_With_Additional_Building.iam, DensGlass.iam, Framing_For_Back_Bedroom_Window.iam, Framing_For_Back_Living_Room_Window.iam, Framing_For_First_Floor.iam, Framing_For_First_Floor_Front_Window.iam]
2024-10-21 Increased height of ceiling to allow for 36" windows
    [Additional_Building.dwg, Additional_Building.iam, Area_With_Additional_Building.iam, DensGlass.iam, DensGlass_With_Dimensions_12_x_60.6875_Inches.ipt, DensGlass_With_Dimensions_12_x_61.084_Inches.ipt, DensGlass_With_Dimensions_25.375_x_36.5_Inches.ipt, DensGlass_With_Dimensions_25.375_x_96_Inches.ipt]
2024-10-21 Added secondary story windows
    [Additional_Building.iam, DensGlass.iam, Framing_For_First_Floor.iam, Framing_For_First_Floor_Window.iam, Framing_For_Roof.iam, Framing_For_Second_Floor.iam, Framing_For_Second_Floor_Window.iam, Plate_With_Length_96_Inches.ipt]
2024-10-22 Added studs for front wall for second story
    [Additional_Building.iam, Area_With_Additional_Building.iam, Framing_For_Roof.iam, Framing_For_Second_Floor.iam, Truss.iam]
2024-10-22 Revised drawings of additional building
    [Additional_Building.iam, Area_With_Additional_Building.iam, Bathroom_Sink.ipt, Bathtub.ipt, Finished_Basement.iam, Framing_For_First_Floor.iam, Plate_With_Length_25_Inches.ipt, Plate_With_Length_26.5625_Inches.ipt]
2024-10-23 Gained informal approval
    [Additional_Building.iam, Area_With_Additional_Building.iam, DensGlass.iam, DensGlass_With_Dimensions_12_x_57.9155_Inches.ipt, DensGlass_With_Dimensions_12_x_61.084_Inches.ipt, DensGlass_With_Dimensions_19.831_x_36.5_Inches.ipt, DensGlass_With_Dimensions_19.831_x_96_Inches.ipt, DensGlass_With_Dimensions_26.168_x_36.5_Inches.ipt]
2024-10-23 Allowed for bedroom in addition to house
    [Area_With_Additional_Building.iam, Earth.ipt, Truss.iam]
2024-10-23 Added additional building to property
    [Finished_House.iam, Property.iam]
2024-11-23 Deepened closet, moved electrical panel, and considered water heater
    [Additional_Building.iam, Area_With_Additional_Building.iam, Floor_System.iam, Framing_For_Bathroom_Window.iam, Framing_For_First_Floor.iam, Plate_With_Length_23.1875_Inches.ipt, Plate_With_Length_25_Inches.ipt]
2024-12-05 Revised elevation and position of sewer
    [Additional_Building.iam, Area_With_Additional_Building.iam, Earth.ipt, Floor_System.iam]
